mvvproject/ReVerSE-U16/u16_nextzx/readme.md

#### NextZX
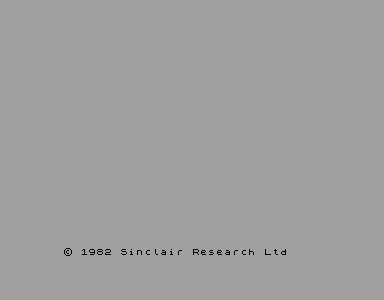
[picture p2: u16_nextzx/screen.png]


- CPU NextZ80@48MHz
- ROM 16K
- RAM 48K
- Video HDMI 640x480@60Hz
- Sound Beeper (Delta-sigma stereo)
- USB Keyboard
