mvvproject/ReVerSE-U16/u16_zx128k/readme.txt

ZX-Spectrum 128K
		CPU: T80@3.5MHz
		RAM: M9K 56K (32K ROM + 8K ROM + 16K RAM)
		SDRAM: 640K (128K + 512K)
		Video: HDMI 640x480@60Hz(ZX-Spectrum screen x2 = H:32+256+32; V=24+192+24)
		Int: 60Hz (h_sync_on and v_sync_on)
		Sound: Stereo (Delta-sigma) AY3-8910 + Beeper
		Keyboard: USB HID Keyboard (F4=CPU Reset, F5=NMI, ScrollLock=Hard Reset)
		DivMMC: 512K (Press Space+F5+F4 to initial, F5=Go to ESXDOS)

22.06.2015	Initial Audio Packets
07.06.2015	Initial release
