mvvproject/ReVerSE-U16/u16_zx48k/readme.md

#### ZX-48K


CPU: NextZ80 @ 50MHz

ROM: 16K

RAM: 48K

Video: HDMI 640x480 @ 60Hz

Sound: Beeper (Delta-sigma stereo)

Keyboard: USB
