mvvproject/ReVerSE-U16/u16_zx48k_t80/readme.txt

ZX-Spectrum 48K

CPU: T80@50MHz
RAM: M9K 64K (16K ROM + 48K RAM)
Video: HDMI 640x480@60Hz(ZX-Spectrum screen x2 = H:32+256+32; V=24+192+24)
Int: 60Hz (h_sync_on and v_sync_on)
Sound: Stereo (Delta-sigma)
Keyboard: USB HID Keyboard
