mvvproject/ReVerSE-U16/u16_board/modules/ubus/readme.txt

ReVerSE-U16 Adapter uBUS

09.06.2015	Rev.A Первая версия
16.09.2015	Rev.B Добавлены светодиоды LED1-8
05.10.2015	Rev.C Добавлена поддержка слотов расширения ZX-Bus, Nemo-Bus, NES, MSX-Bus
