mvvproject/ReVerSE-U16/u16_msx/readme.txt

OneChipMSX (сборка 20170405)
основана на http://www.caro.su/msx/ocm_de1.htm

1) Отформатируйте SD карту в FAT16 на PC
2) Запишите на неё первым файлом bios_m2p.rom из архива sd.zip
3) Запишите остальные файлы из архива sd.zip
4) Подключите к плате ReVerSE-U16 кабель HDMI, USB клавиатуру, аудио (используйте модуль https://github.com/mvvproject/ReVerSE-U16/tree/master/u16_board/modules/audio) и включите питание платы
5) Откройте в Quartus Programmer файл .jic
6) Запрограммируйте ReVerSE-U16 и отключите питание ReVerSE-U16
7) Вставте SD карту в ReVerSE-U16 и включите питание
8) Для запуска SYMBOS наберите symb и нажмите ENTER
9) Для запуска игры наберите cd games и нажмите ENTER, набирите dir, набирите romload mg2-uk /s

Управление указателем в SYMBOS с помощью клавиш F6 + курсорные клавиши (вверх, вниз, влево, вправо, пробел)

Специальные клавиши на клавиатуре:
Page Up		Добавить громкость звука
Page Down	Уменьшить громкость звука
F9		Добавить уровень звука в канале PSG
F9+SHIFT	Уменьшить уровень звука в канале PSG
F10		Добавить уровень звука в канале SCC
F10+SHIFT	Уменьшить уровень звука в канале SCC
F11		Добавить уровень звука в канале OPLL
F11+SHIFT	Уменьшить уровень звука в канале OPLL
F12		Переключение тактовой частоты процессора
