mvvproject/ReVerSE-U16/u16_board/modules/audio/u16_audio.jpg

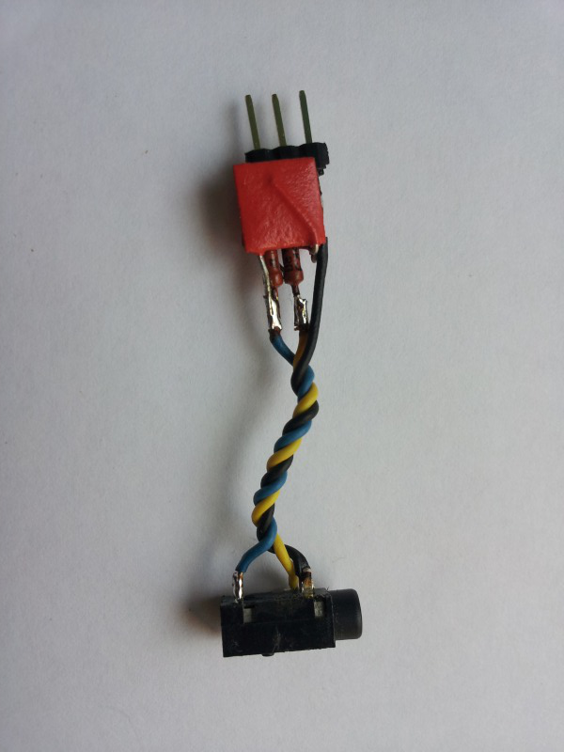
u16_board/modules/audio/u16_audio.jpg
