mvvproject/ReVerSE-U16/u16_board/modules/audio/u16c_audio.png

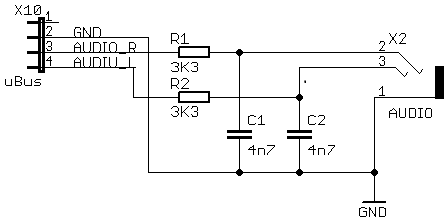
u16_board/modules/audio/u16c_audio.png
