mvvproject/ReVerSE-U16/u16_board/modules/ubus/photo/ubus_brd_rev_b_top.jpg

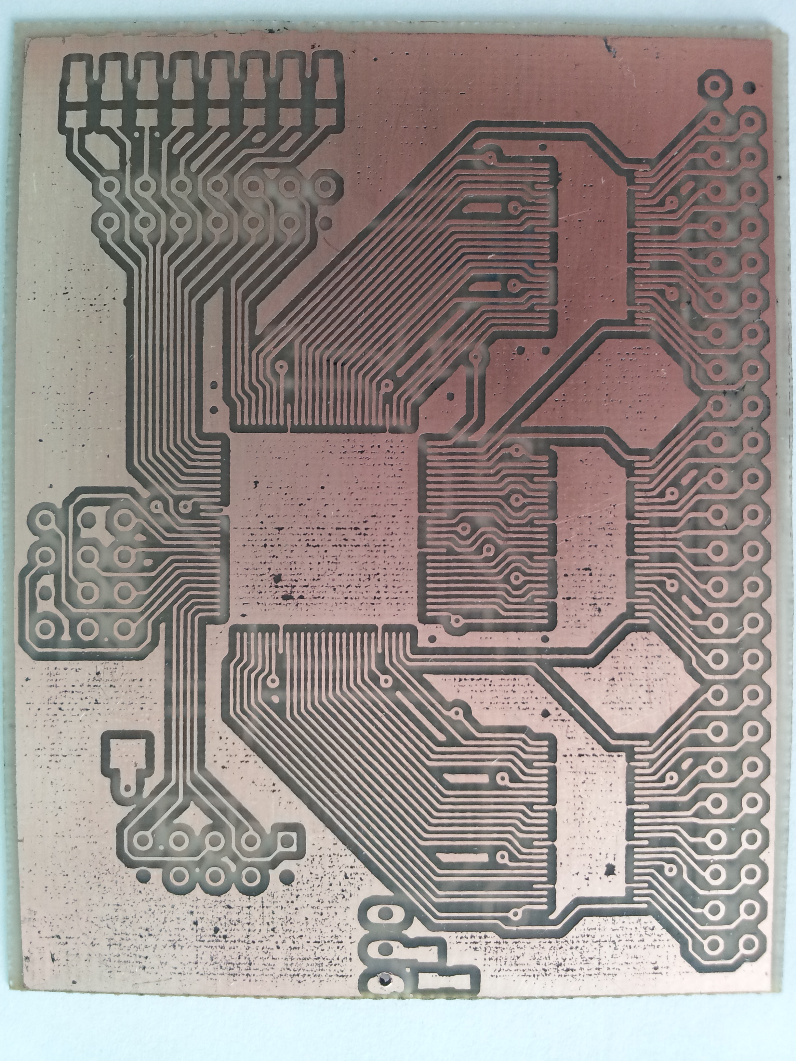
u16_board/modules/ubus/photo/ubus_brd_rev_b_top.jpg
