mvvproject/ReVerSE-U16/u16_board/modules/ubus/photo/ubus_rev_b_bottom.jpg

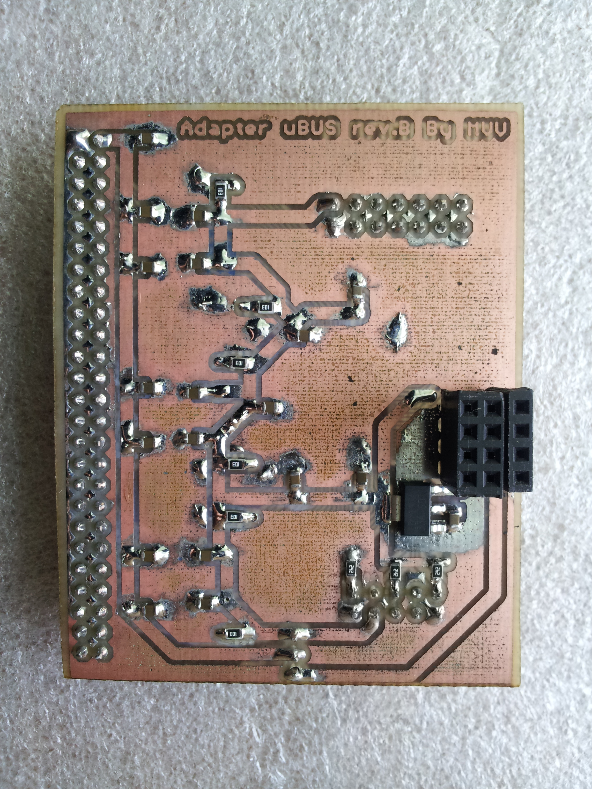
u16_board/modules/ubus/photo/ubus_rev_b_bottom.jpg
