mvvproject/ReVerSE-U16/u16_board/modules/ubus/ubus_rev_b.png

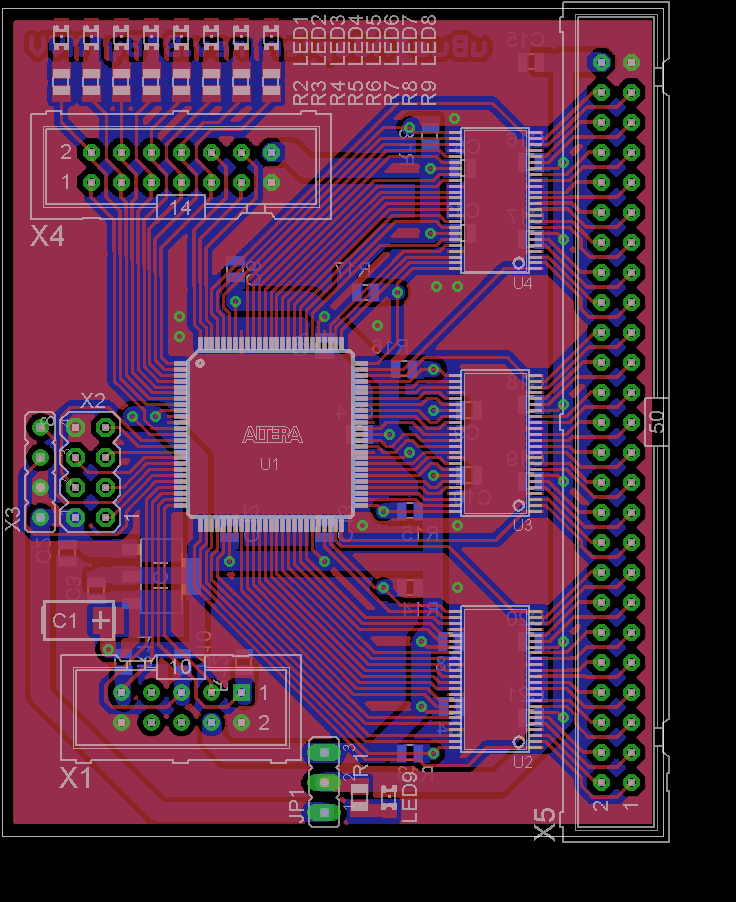
u16_board/modules/ubus/ubus_rev_b.png
