mvvproject/ReVerSE-U16/u16_board/modules/usb_blaster/pdf/usb_blaster_foto.jpg

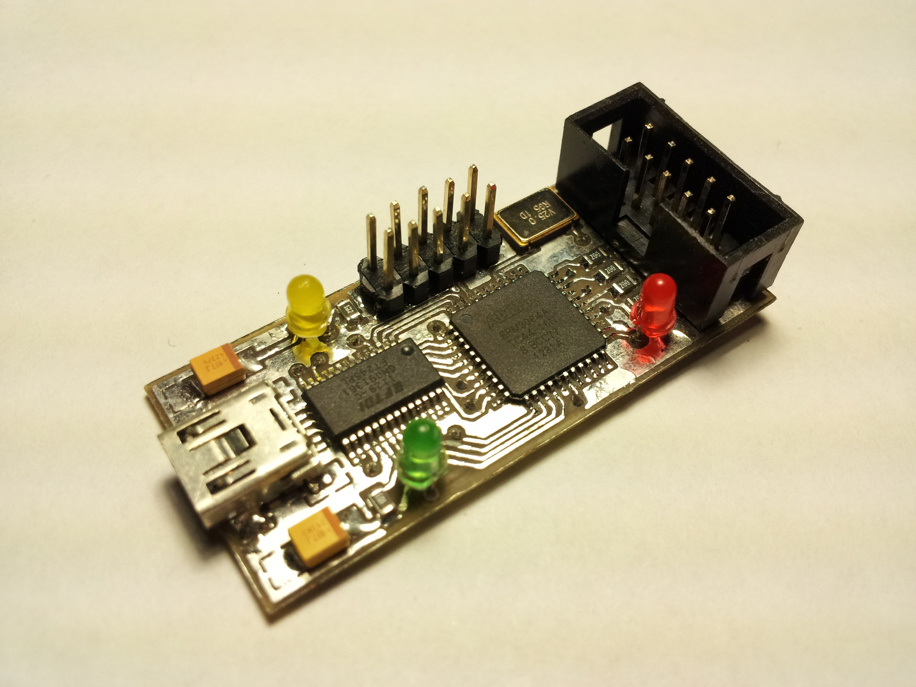
u16_board/modules/usb_blaster/pdf/usb_blaster_foto.jpg
