mvvproject/ReVerSE-U16/u16_board/modules/vdac2/u16c_vdac2b_sch.png

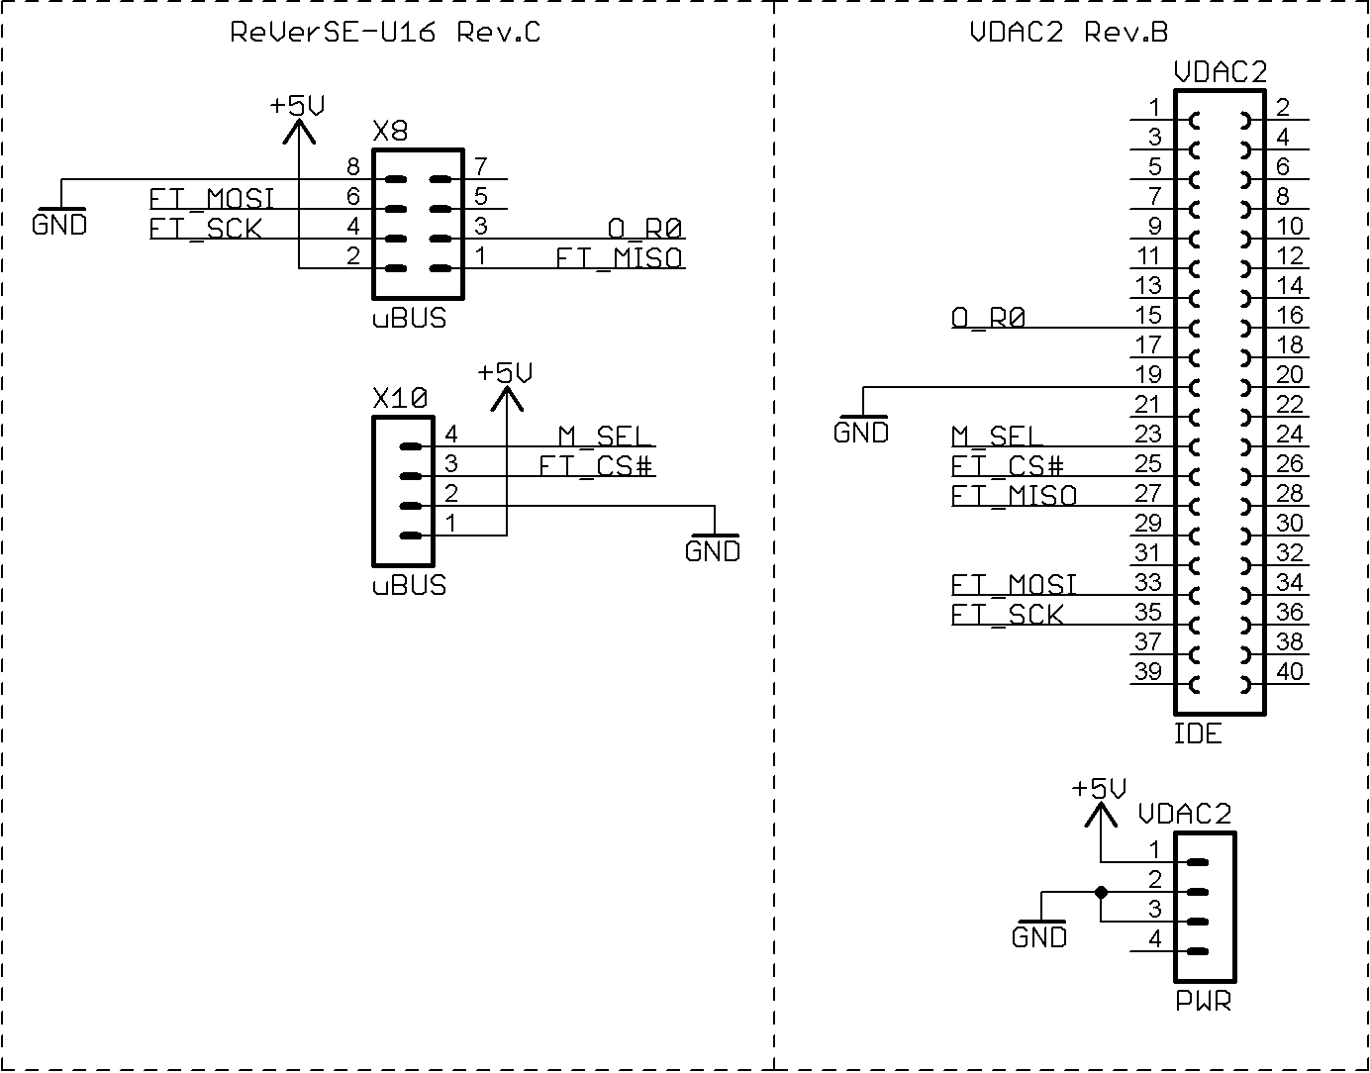
u16_board/modules/vdac2/u16c_vdac2b_sch.png
