mvvproject/ReVerSE-U16/u16_board/modules/vga/u16_hdmi2vga.jpg

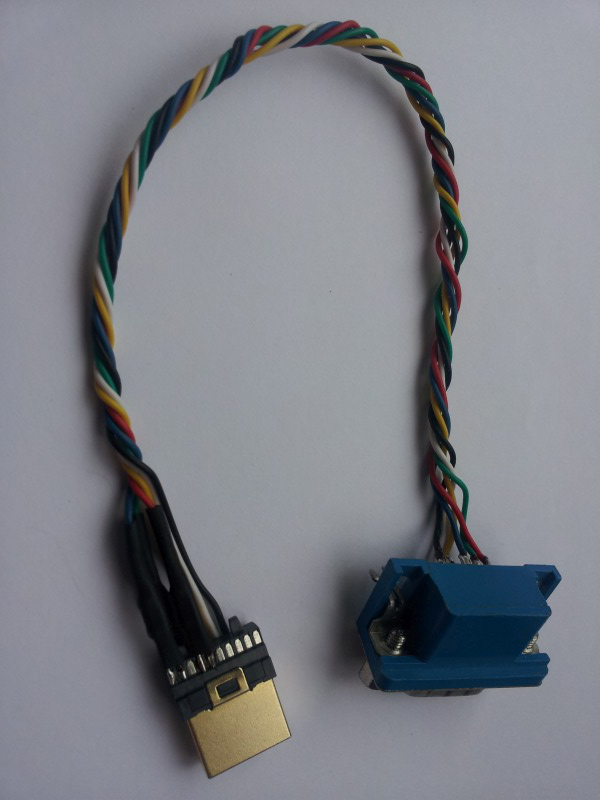
u16_board/modules/vga/u16_hdmi2vga.jpg
