mvvproject/ReVerSE-U16/u16_board/u16_board_rev_c/images/u16c_box_brd.jpg

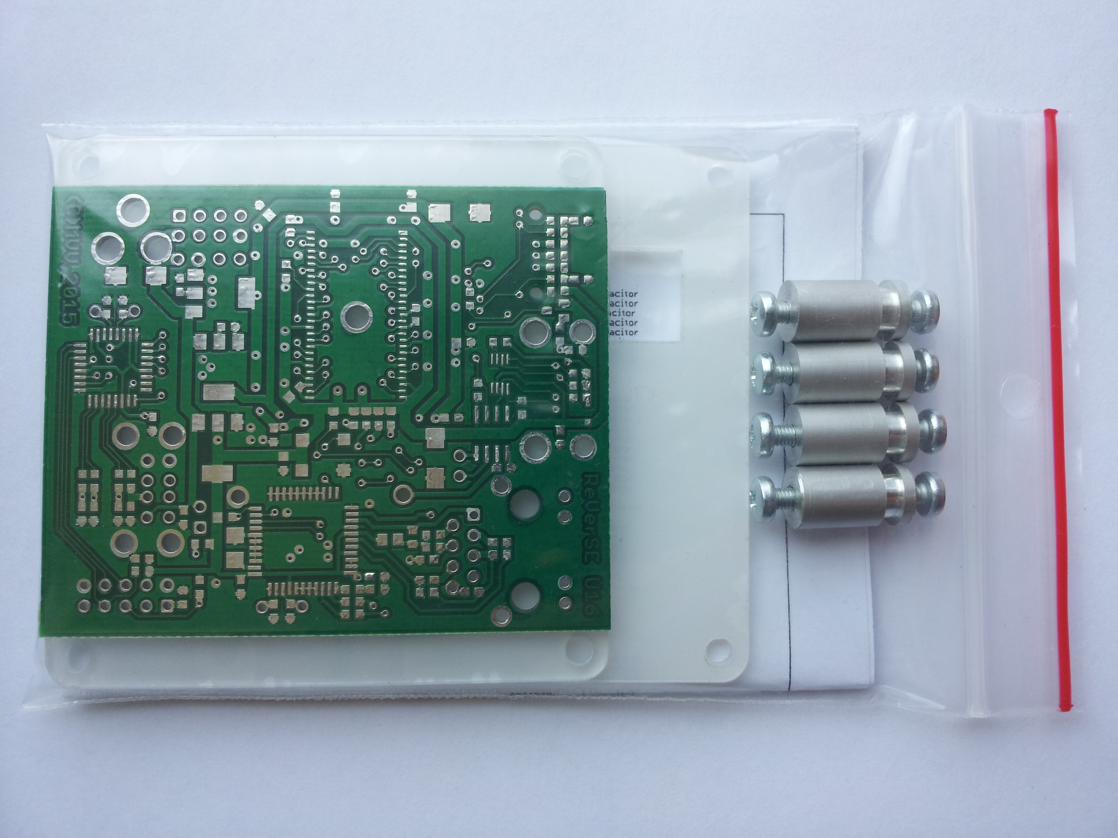
u16_board/u16_board_rev_c/images/u16c_box_brd.jpg
