mvvproject/ReVerSE-U16/u16_board/u16_board_rev_c/images/u16c_brd1.jpg

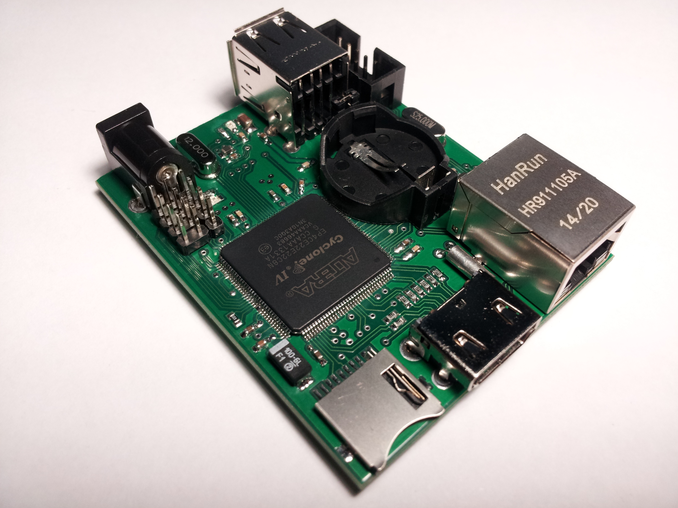
u16_board/u16_board_rev_c/images/u16c_brd1.jpg
