mvvproject/ReVerSE-U16/u16_zet/flash/JIC.JPG

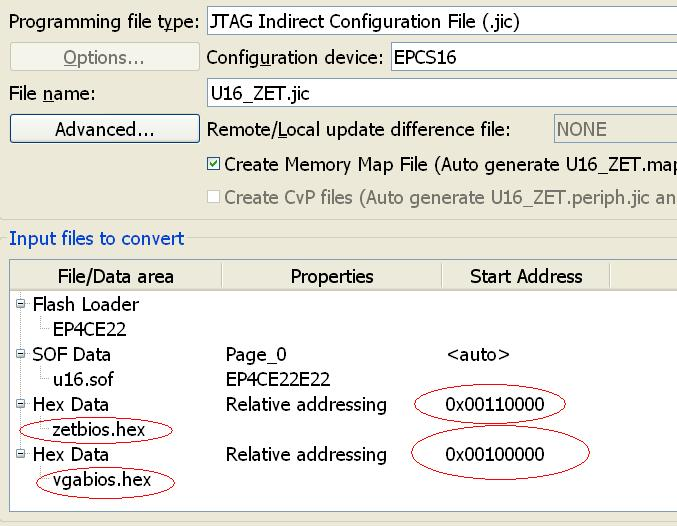
u16_zet/flash/JIC.JPG
