mvvproject/ReVerSE-U16/u16_zet/todo/Lo-tech 2MB EMS Board/Lo-tech-2MB-EMS-Board-tested.jpg

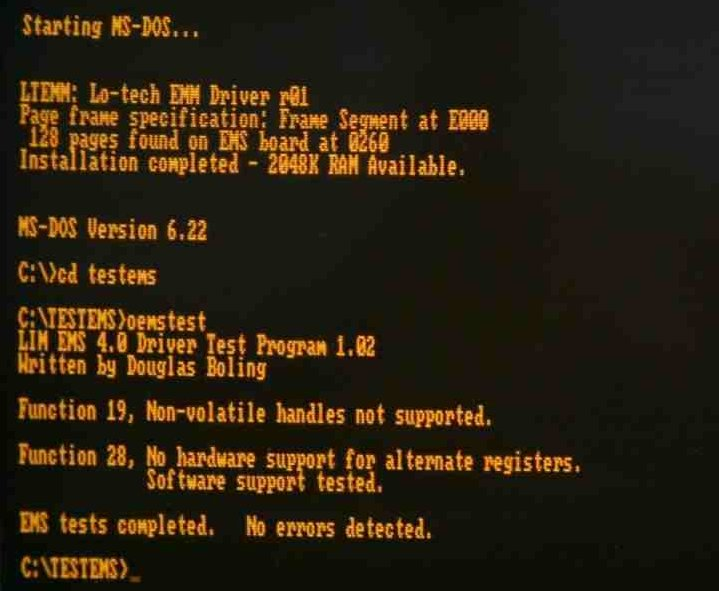
u16_zet/todo/Lo-tech 2MB EMS Board/Lo-tech-2MB-EMS-Board-tested.jpg
