mvvproject/ReVerSE-U16/u16_board/modules/v2debug/v2debug.jpg

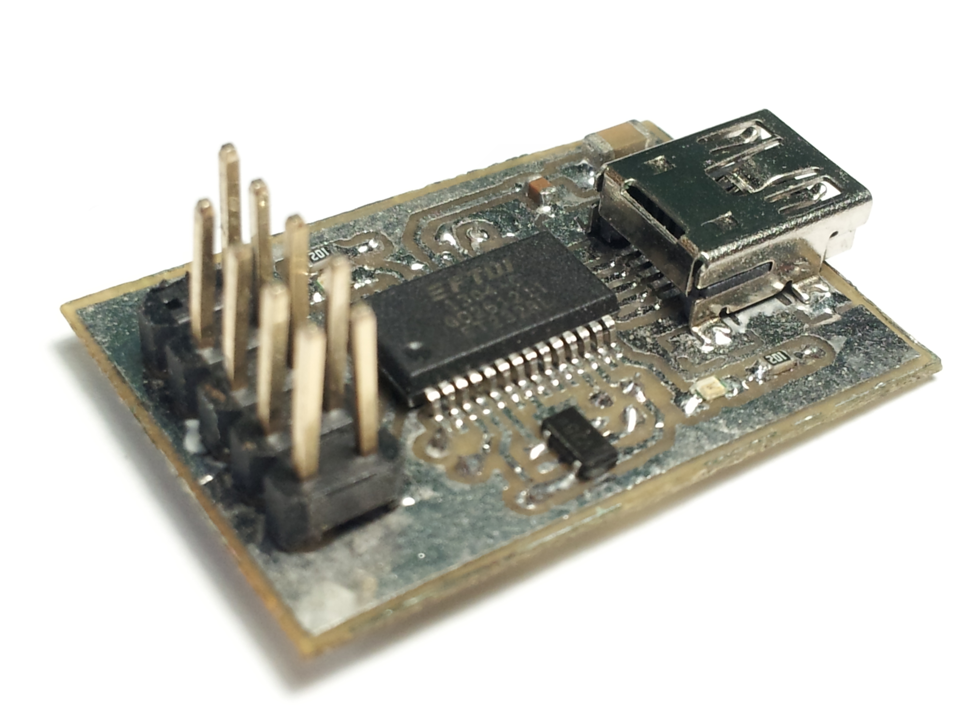
u16_board/modules/v2debug/v2debug.jpg
