mvvproject/ReVerSE-U16/u16_board/modules/v2debug/v2debug.pdf

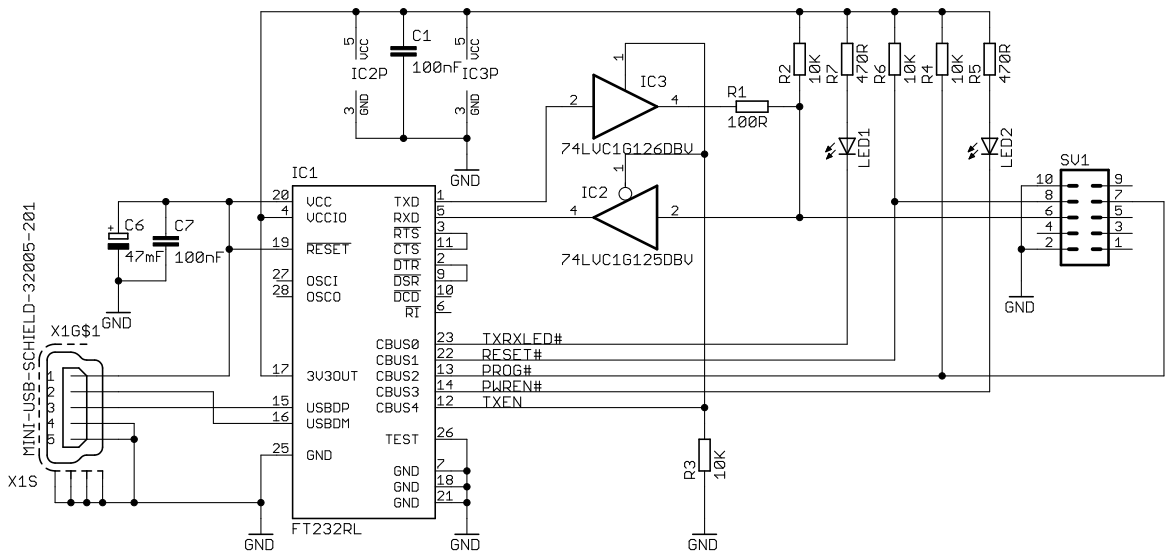
[picture p47: page 1]

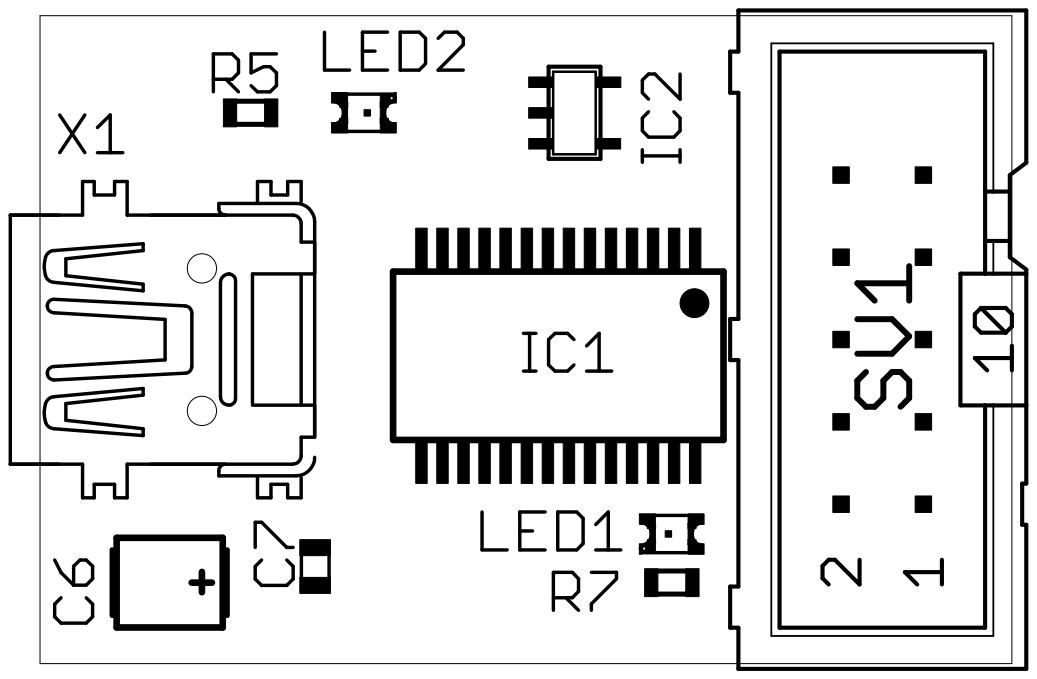
[picture p48: page 2]

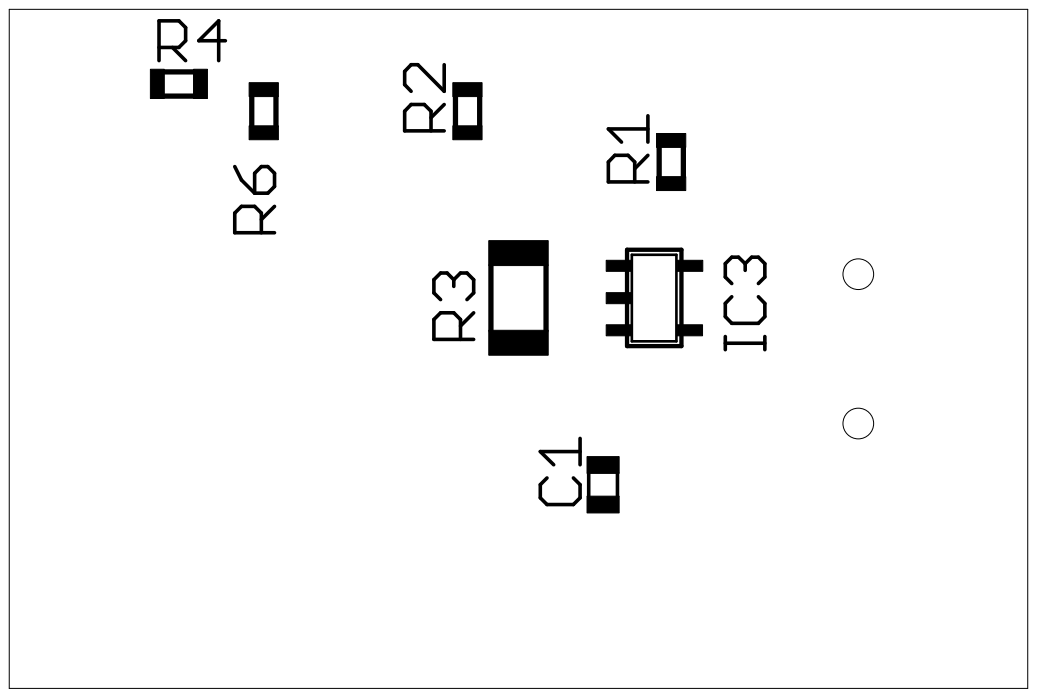
[picture p49: page 3]

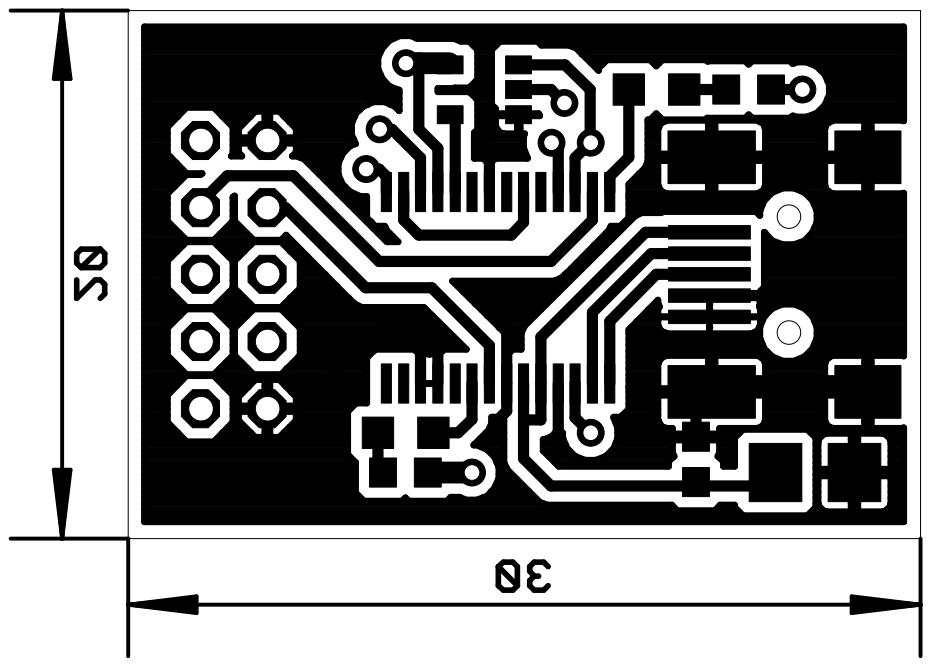
[picture p50: page 4]

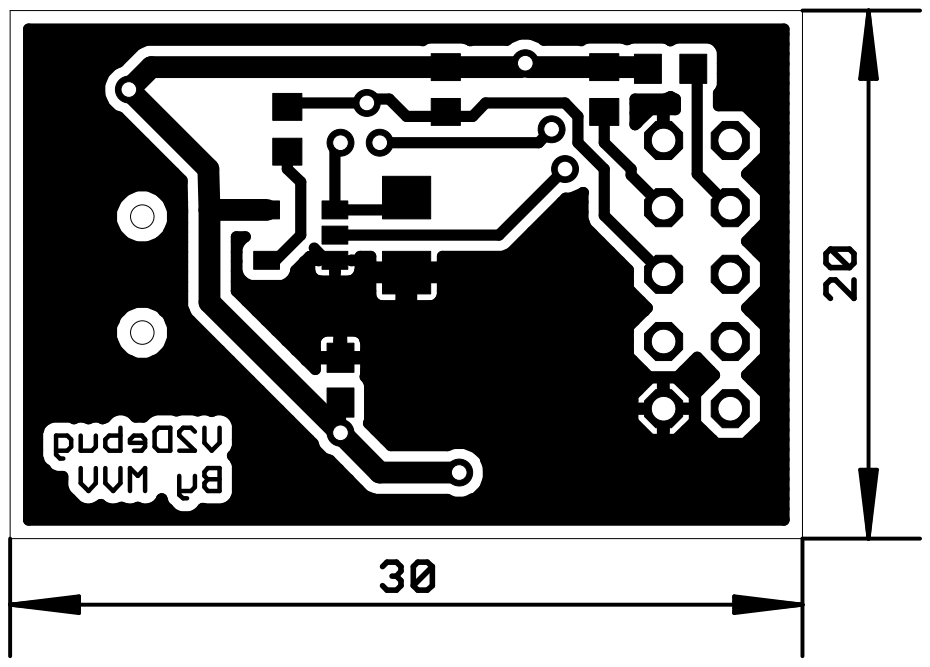
[picture p51: page 5]
