mvvproject/ReVerSE-U16/u16_board/modules/ubus/ubus_rev_b_sch.pdf

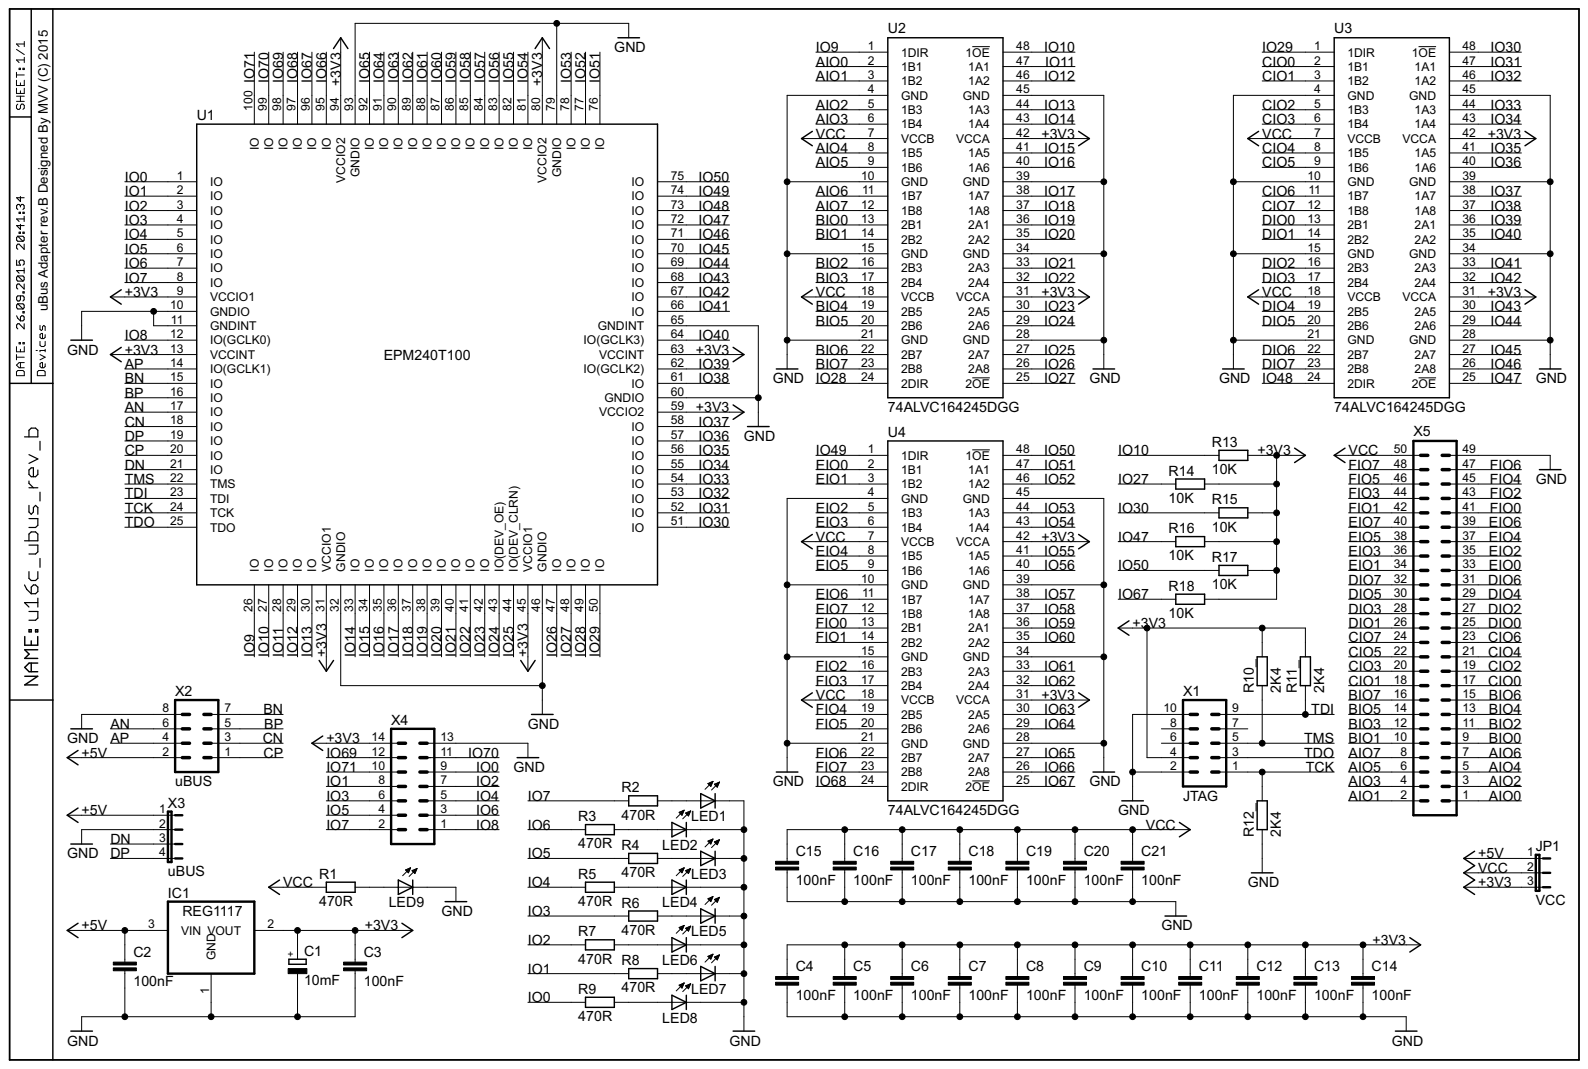
[picture p52: page 1]

uBus Adapter rev.B Designed By MVV (C) 2015

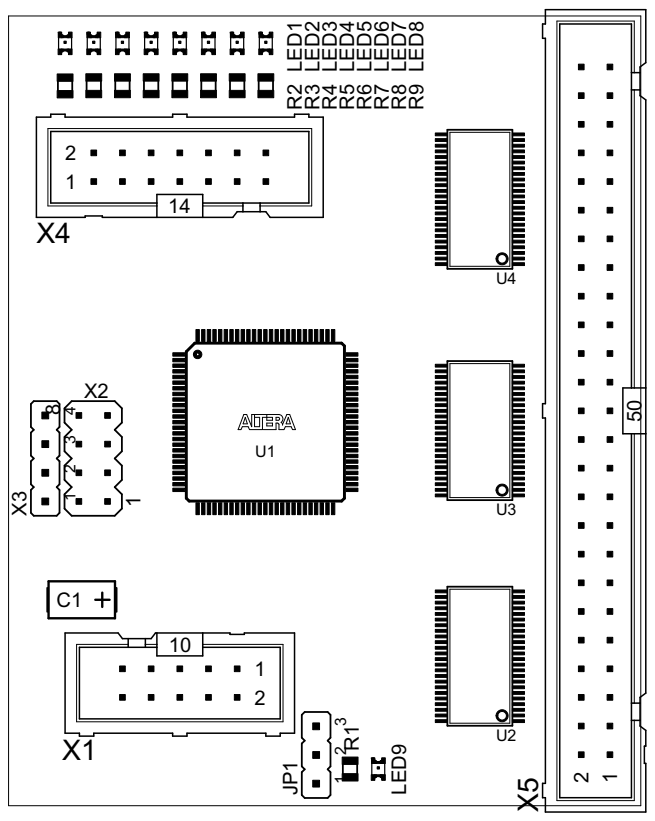
[picture p53: page 2]

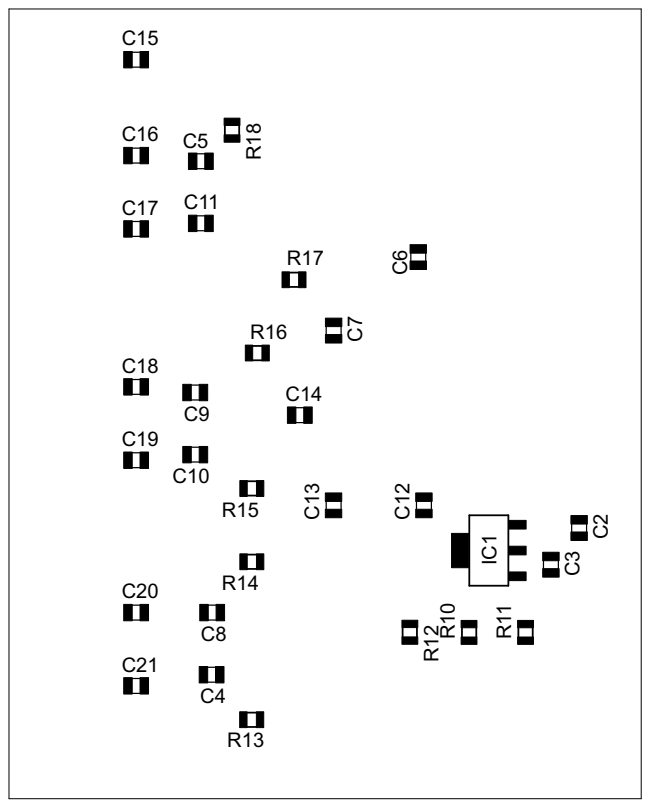
[picture p54: page 3]

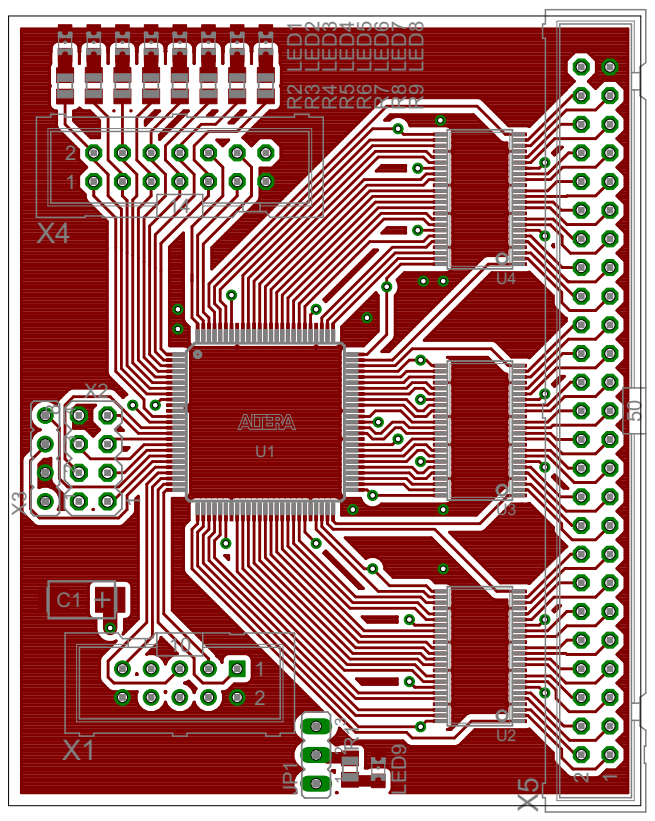
[picture p55: page 4]

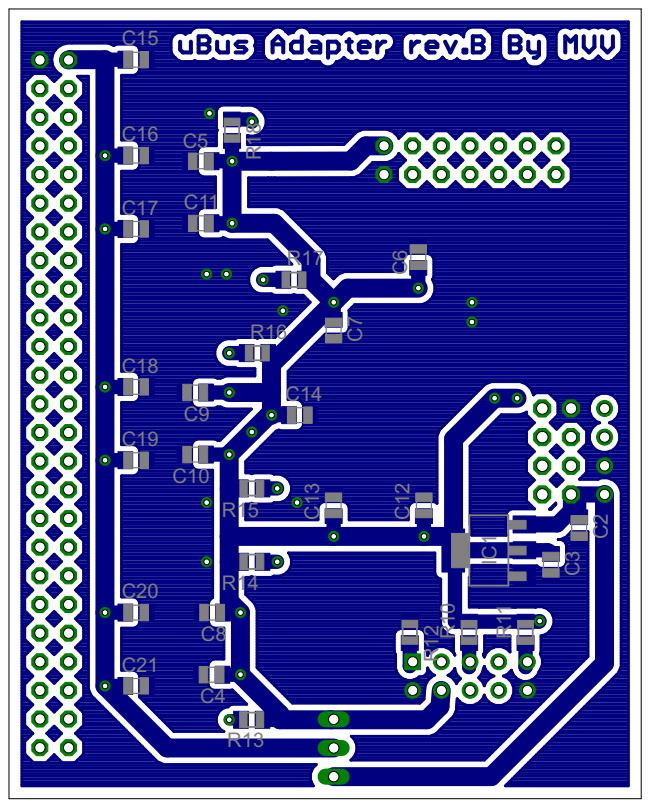
[picture p56: page 5]
