mvvproject/ReVerSE-U16/u16_board/modules/vga/u16_hdmi2vga.pdf

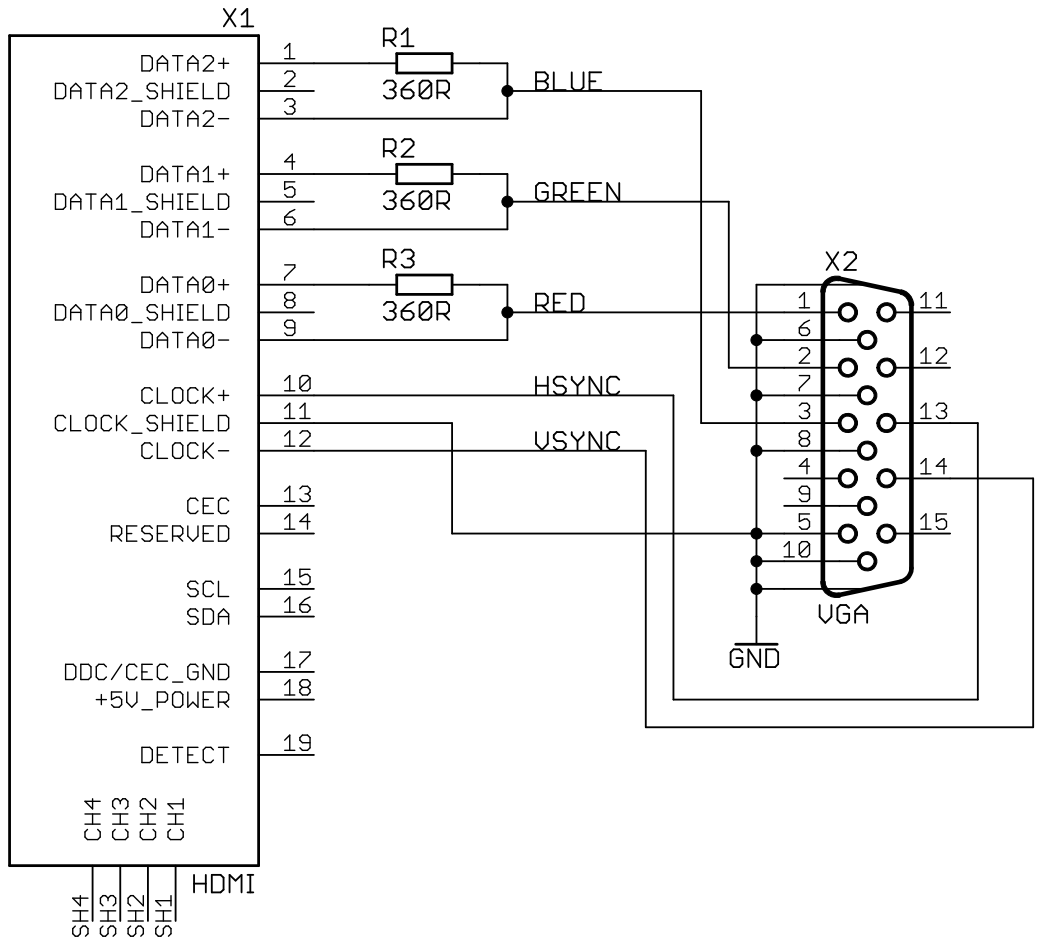
[picture p57: page 1]
