mvvproject/ReVerSE-U16/u16_board/modules/usb_blaster/pdf/usb_blaster_bot.pdf

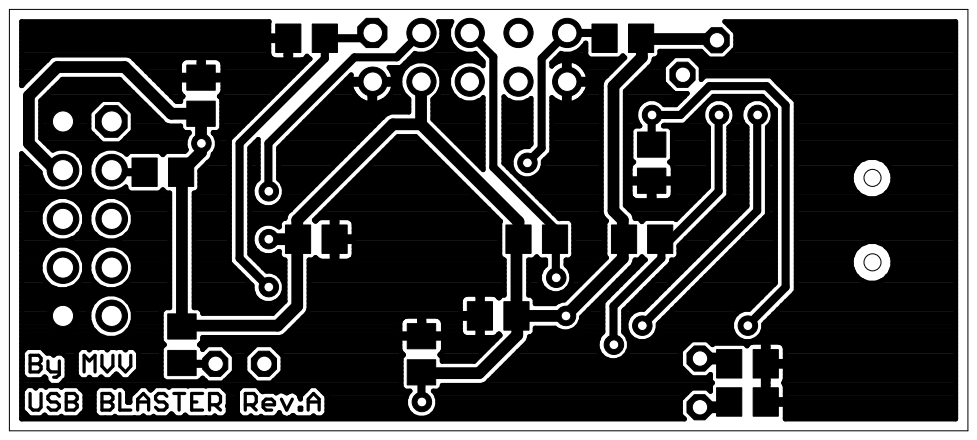
[picture p58: page 1]
