mvvproject/ReVerSE-U16/u16_board/modules/usb_blaster/pdf/usb_blaster_doca.pdf

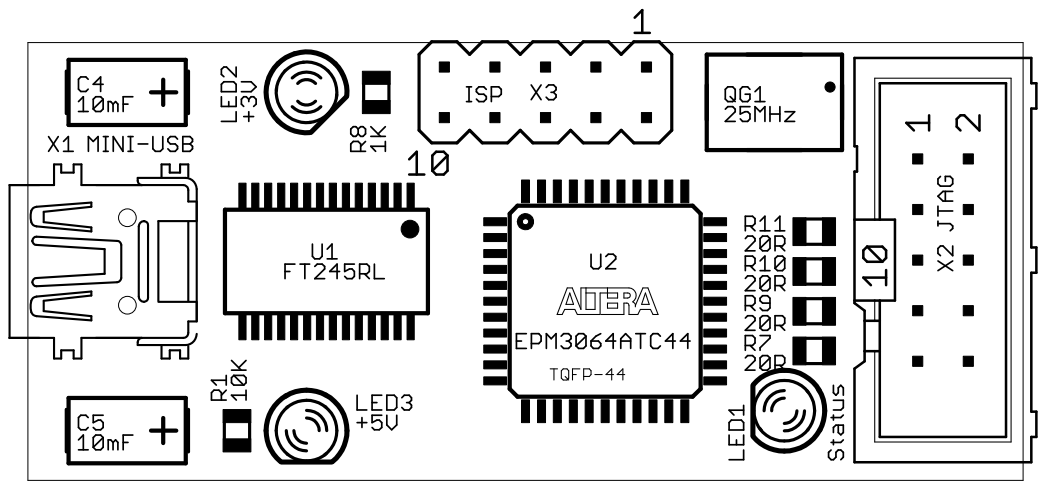
[picture p59: page 1]
