mvvproject/ReVerSE-U16/u16_board/modules/usb_blaster/pdf/usb_blaster_docb.pdf

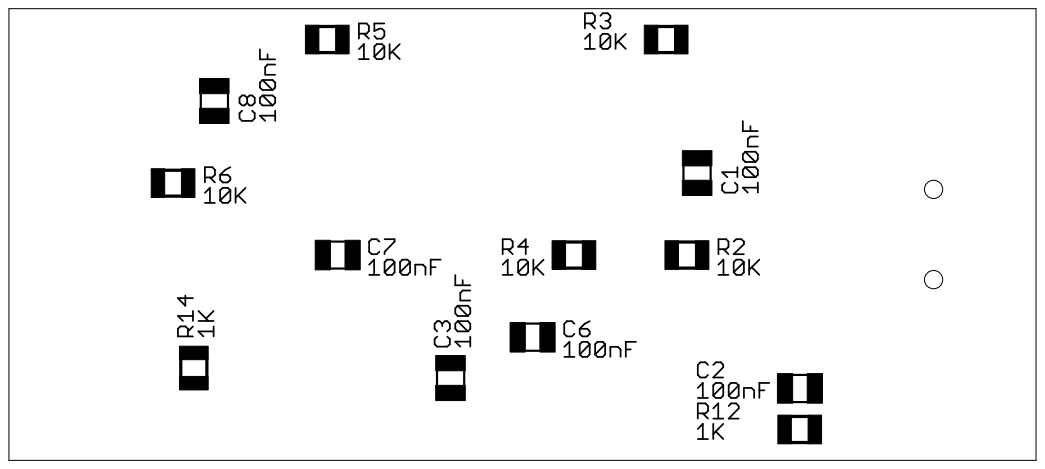
[picture p60: page 1]
