mvvproject/ReVerSE-U16/u16_board/modules/usb_blaster/pdf/usb_blaster_rev_a.pdf

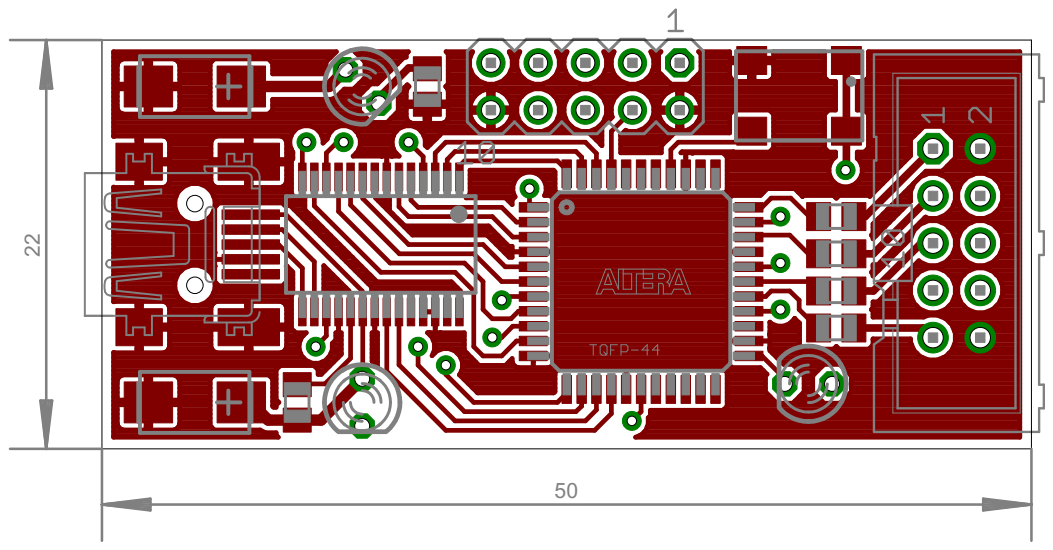
[picture p61: page 1]
