mvvproject/ReVerSE-U16/u16_board/modules/usb_blaster/pdf/usb_blaster_sch.pdf

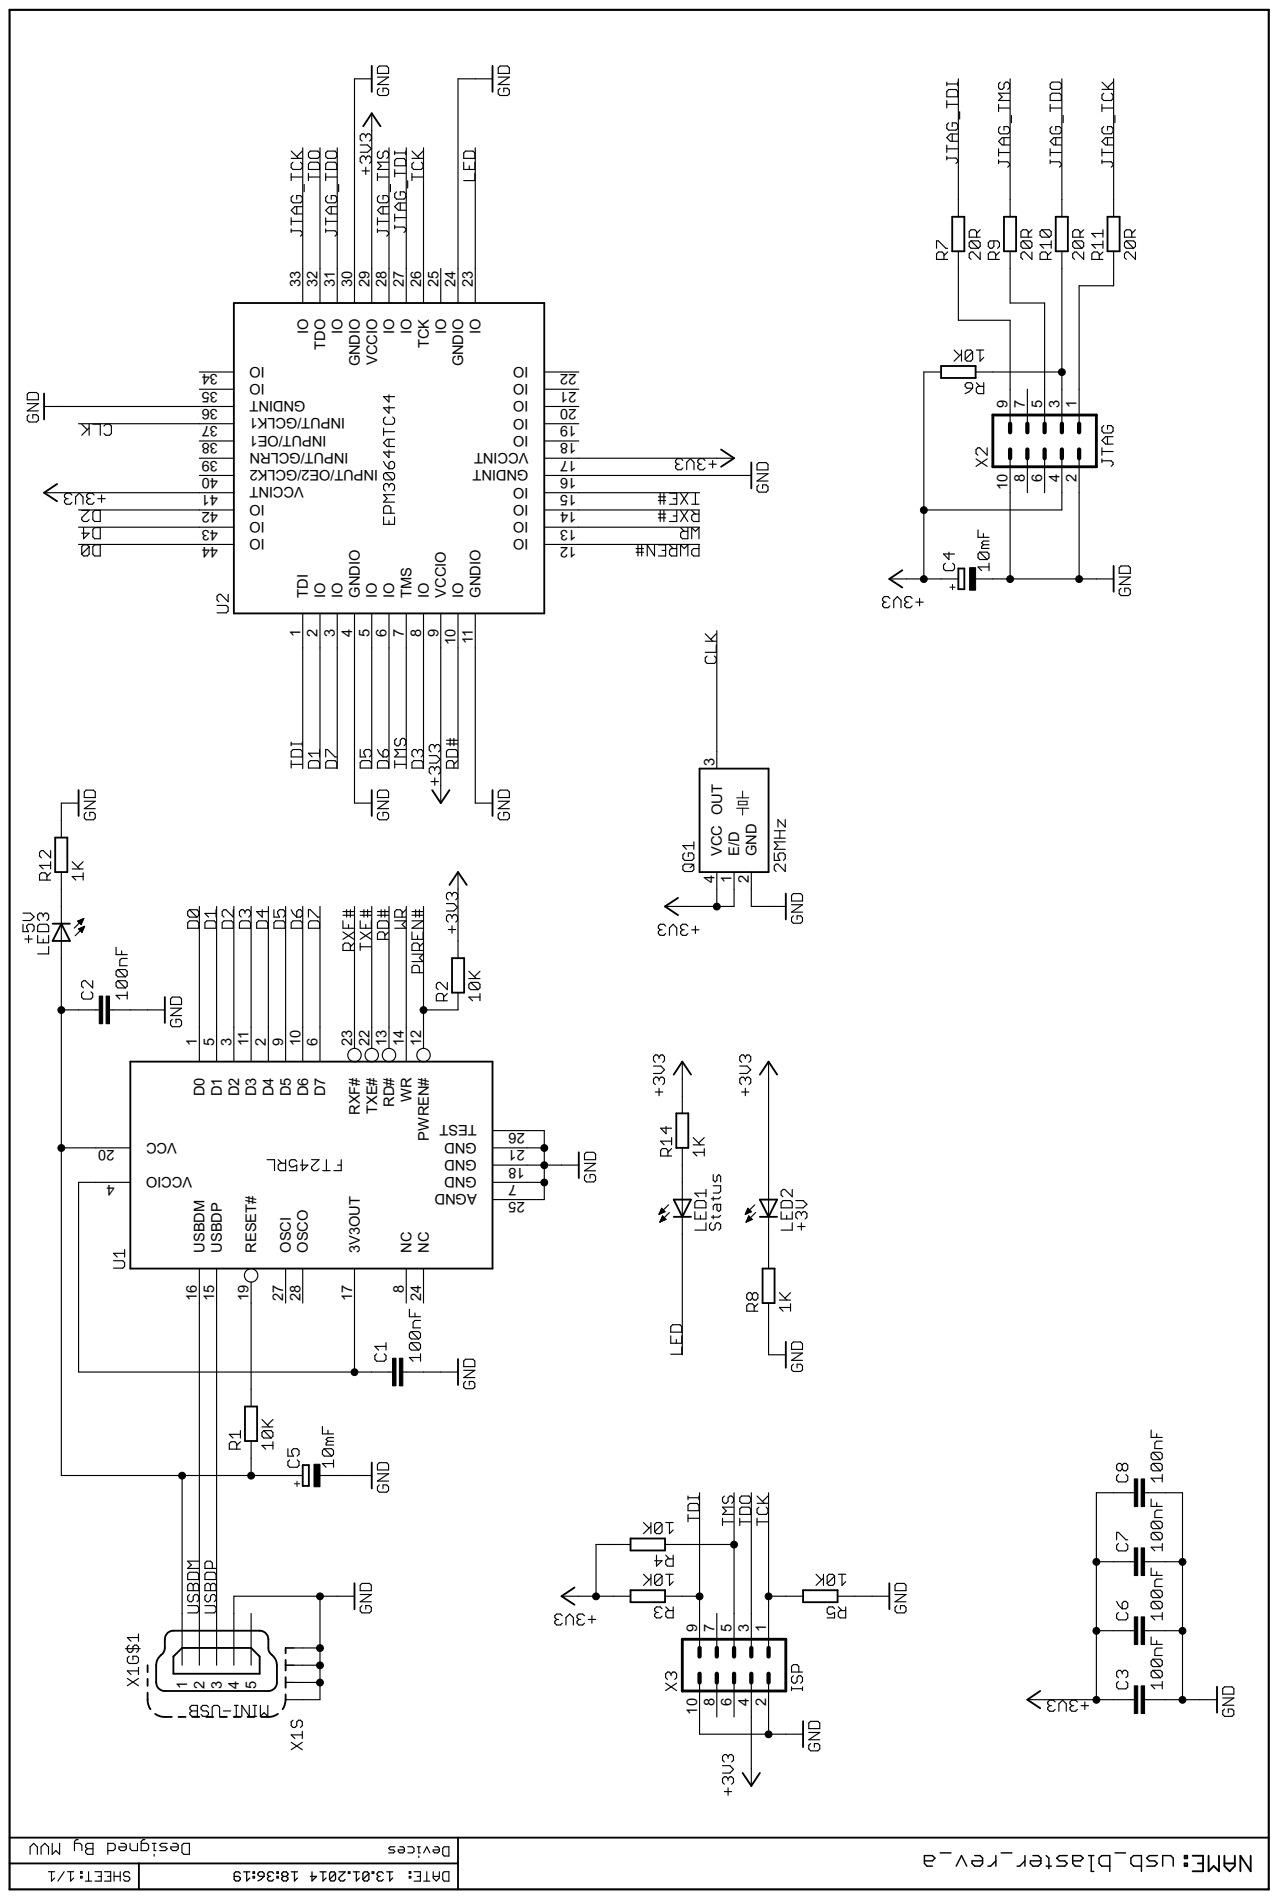
[picture p62: page 1]
