mvvproject/ReVerSE-U16/u16_board/modules/usb_blaster/pdf/usb_blaster_top.pdf

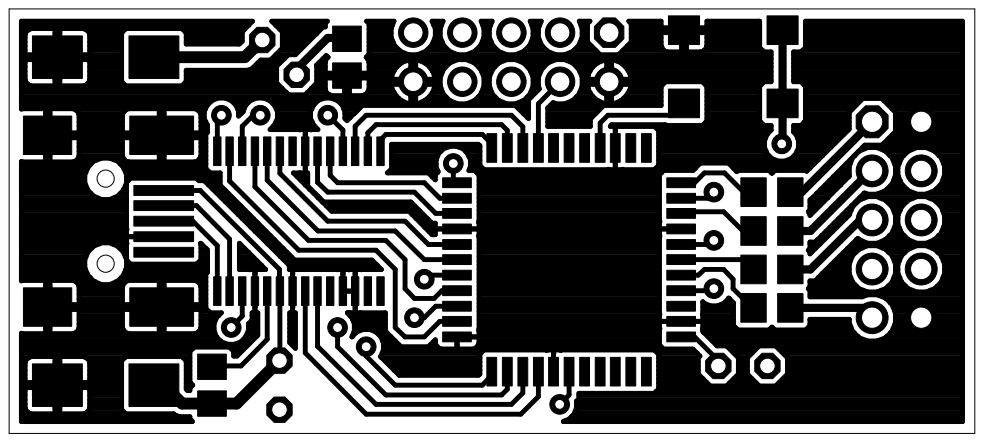
[picture p63: page 1]
