mvvproject/ReVerSE-U16/u16_board/u16_board_rev_c/manuals/u16_sch_rev_c.pdf

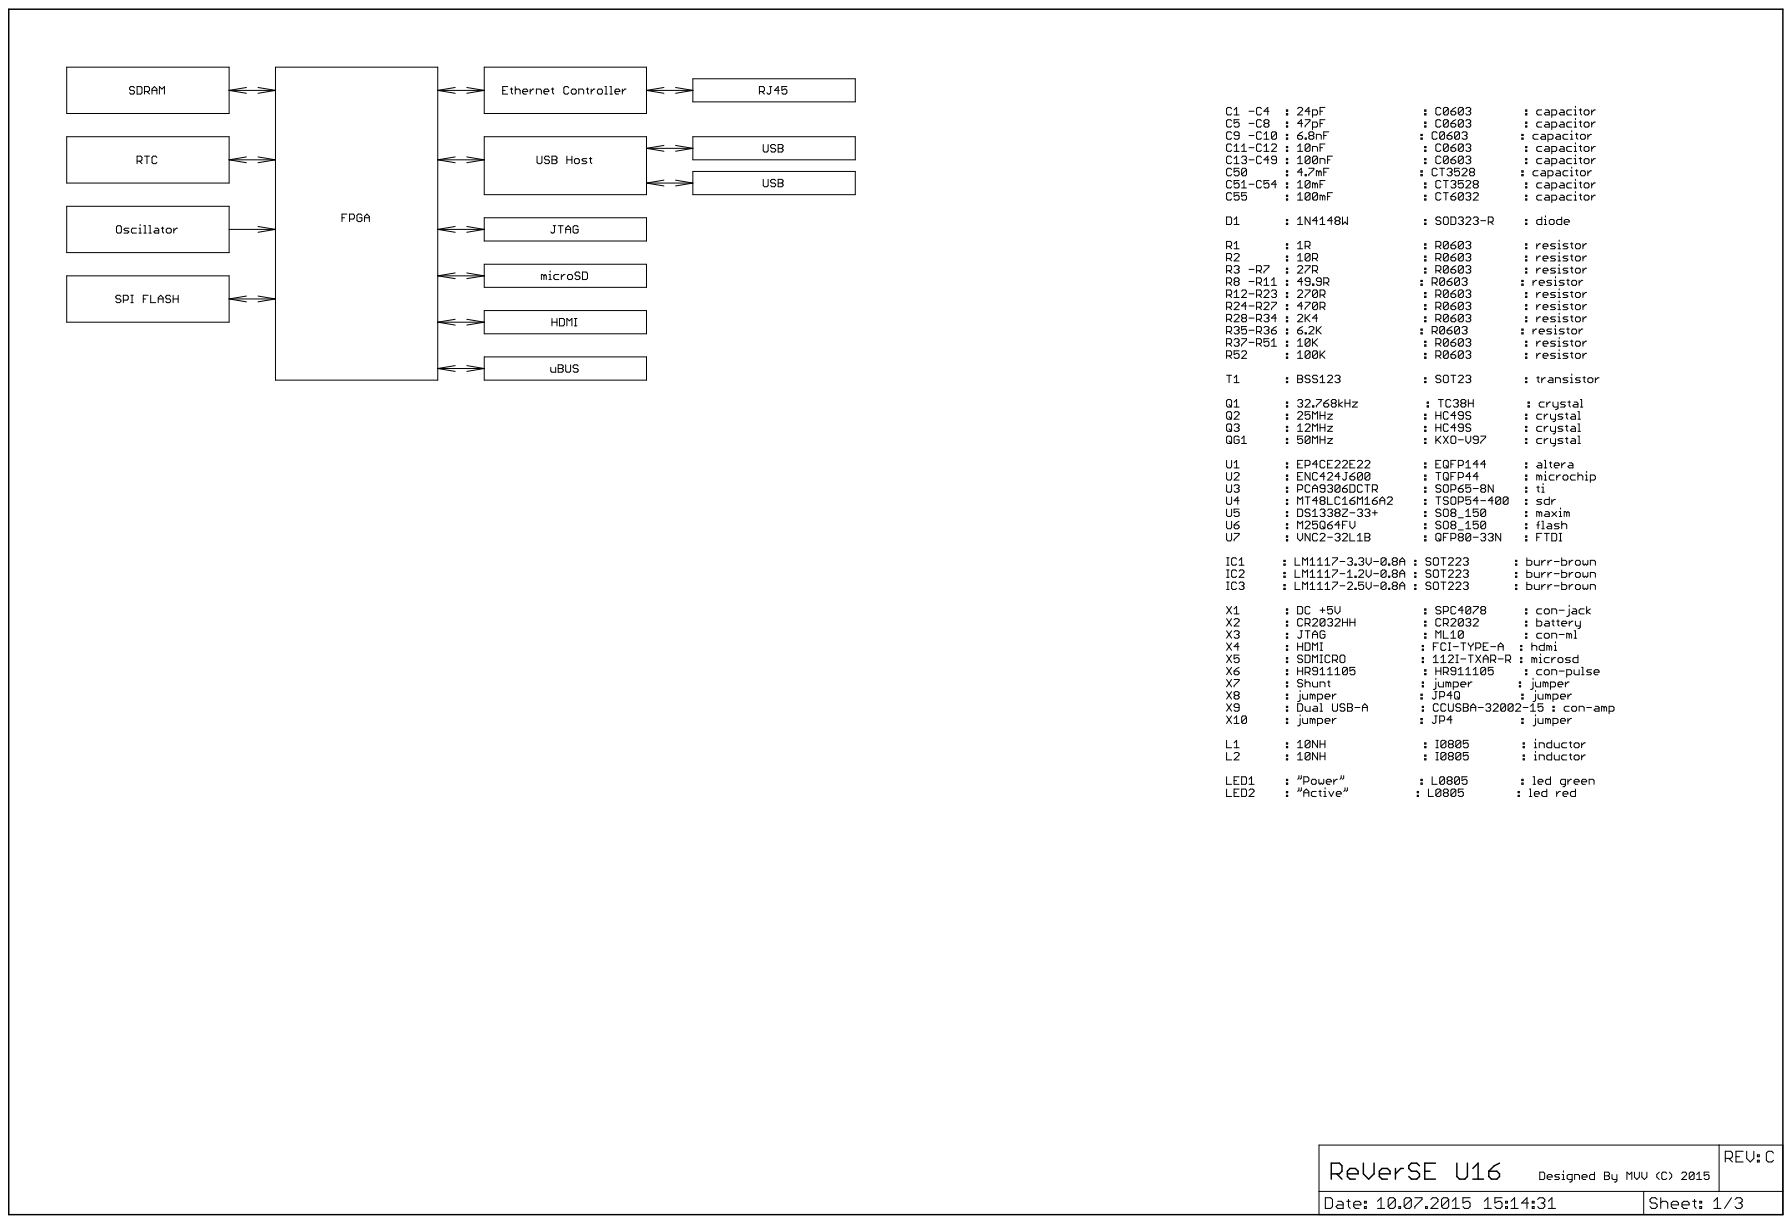
[picture p64: page 1]

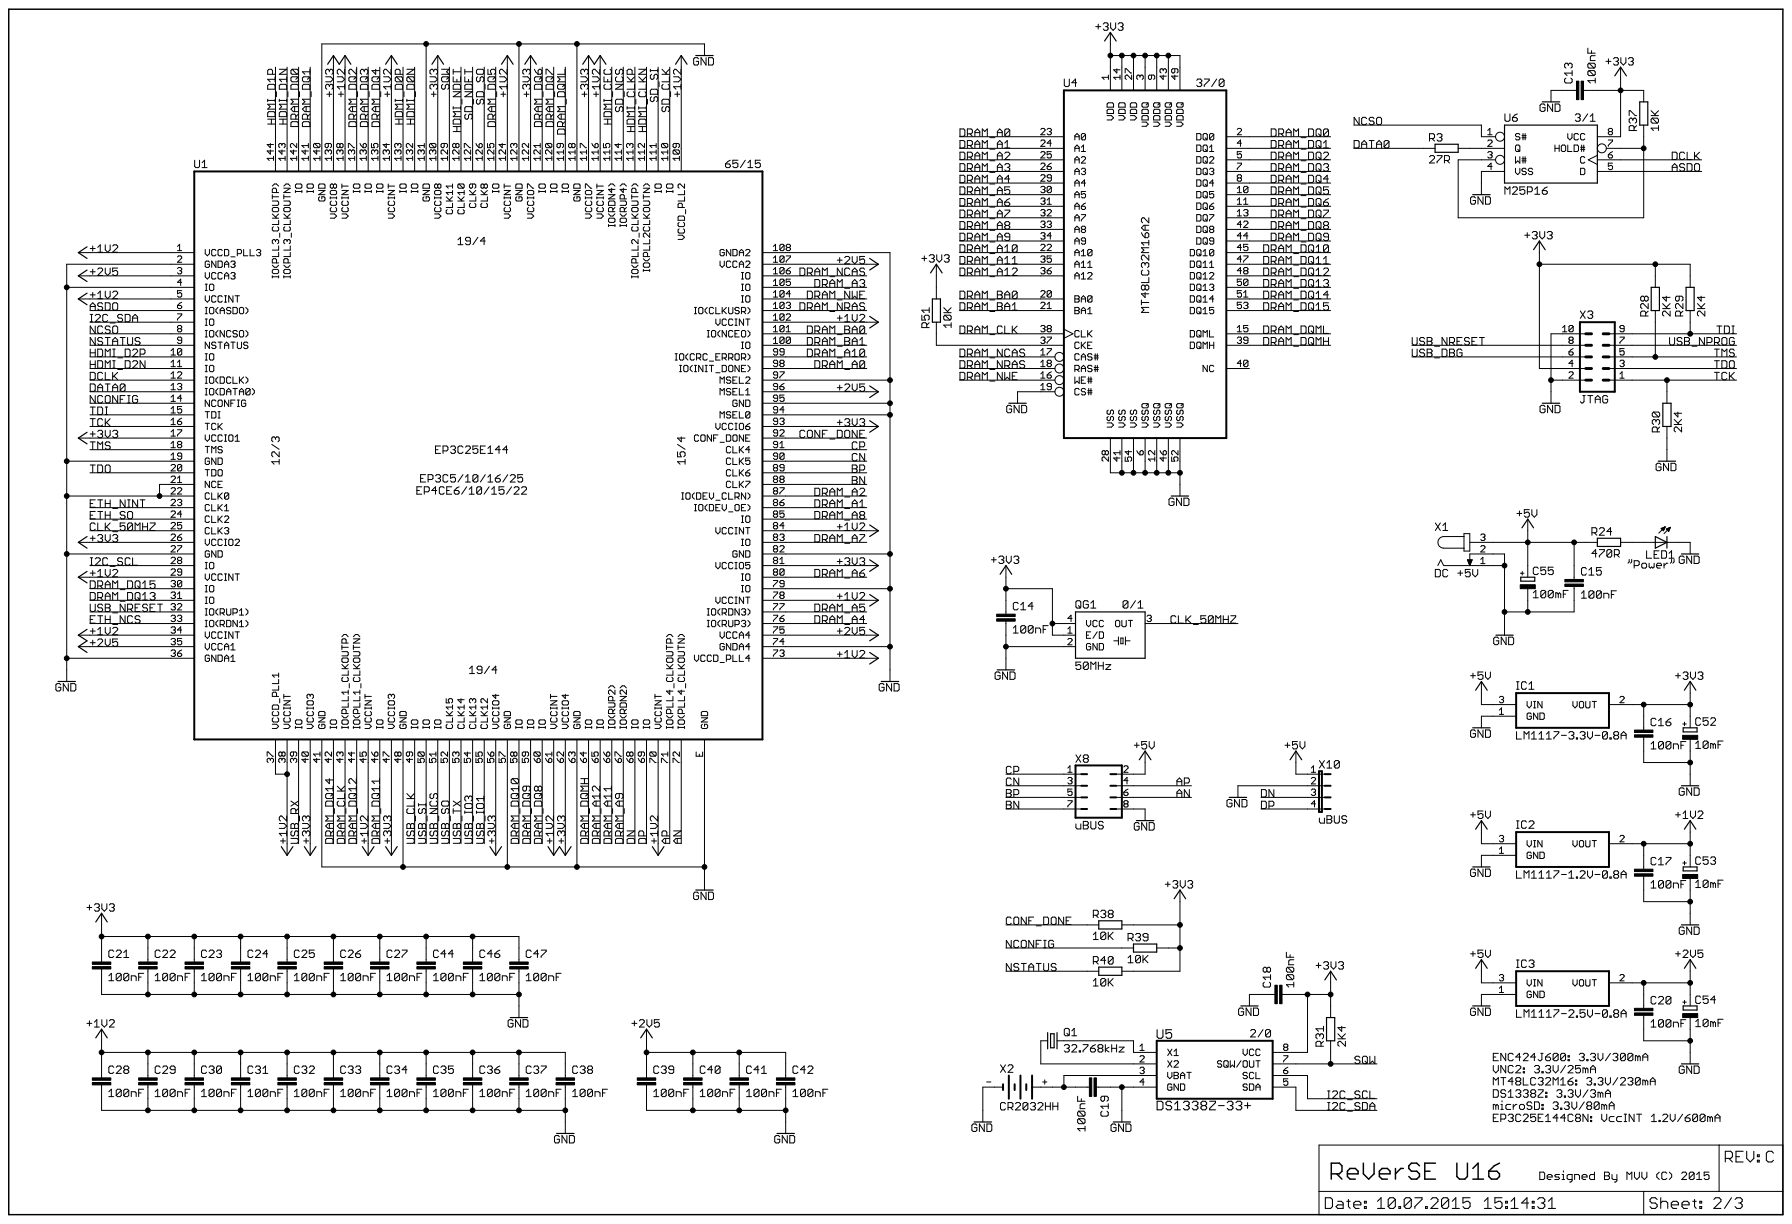
[picture p65: page 2]

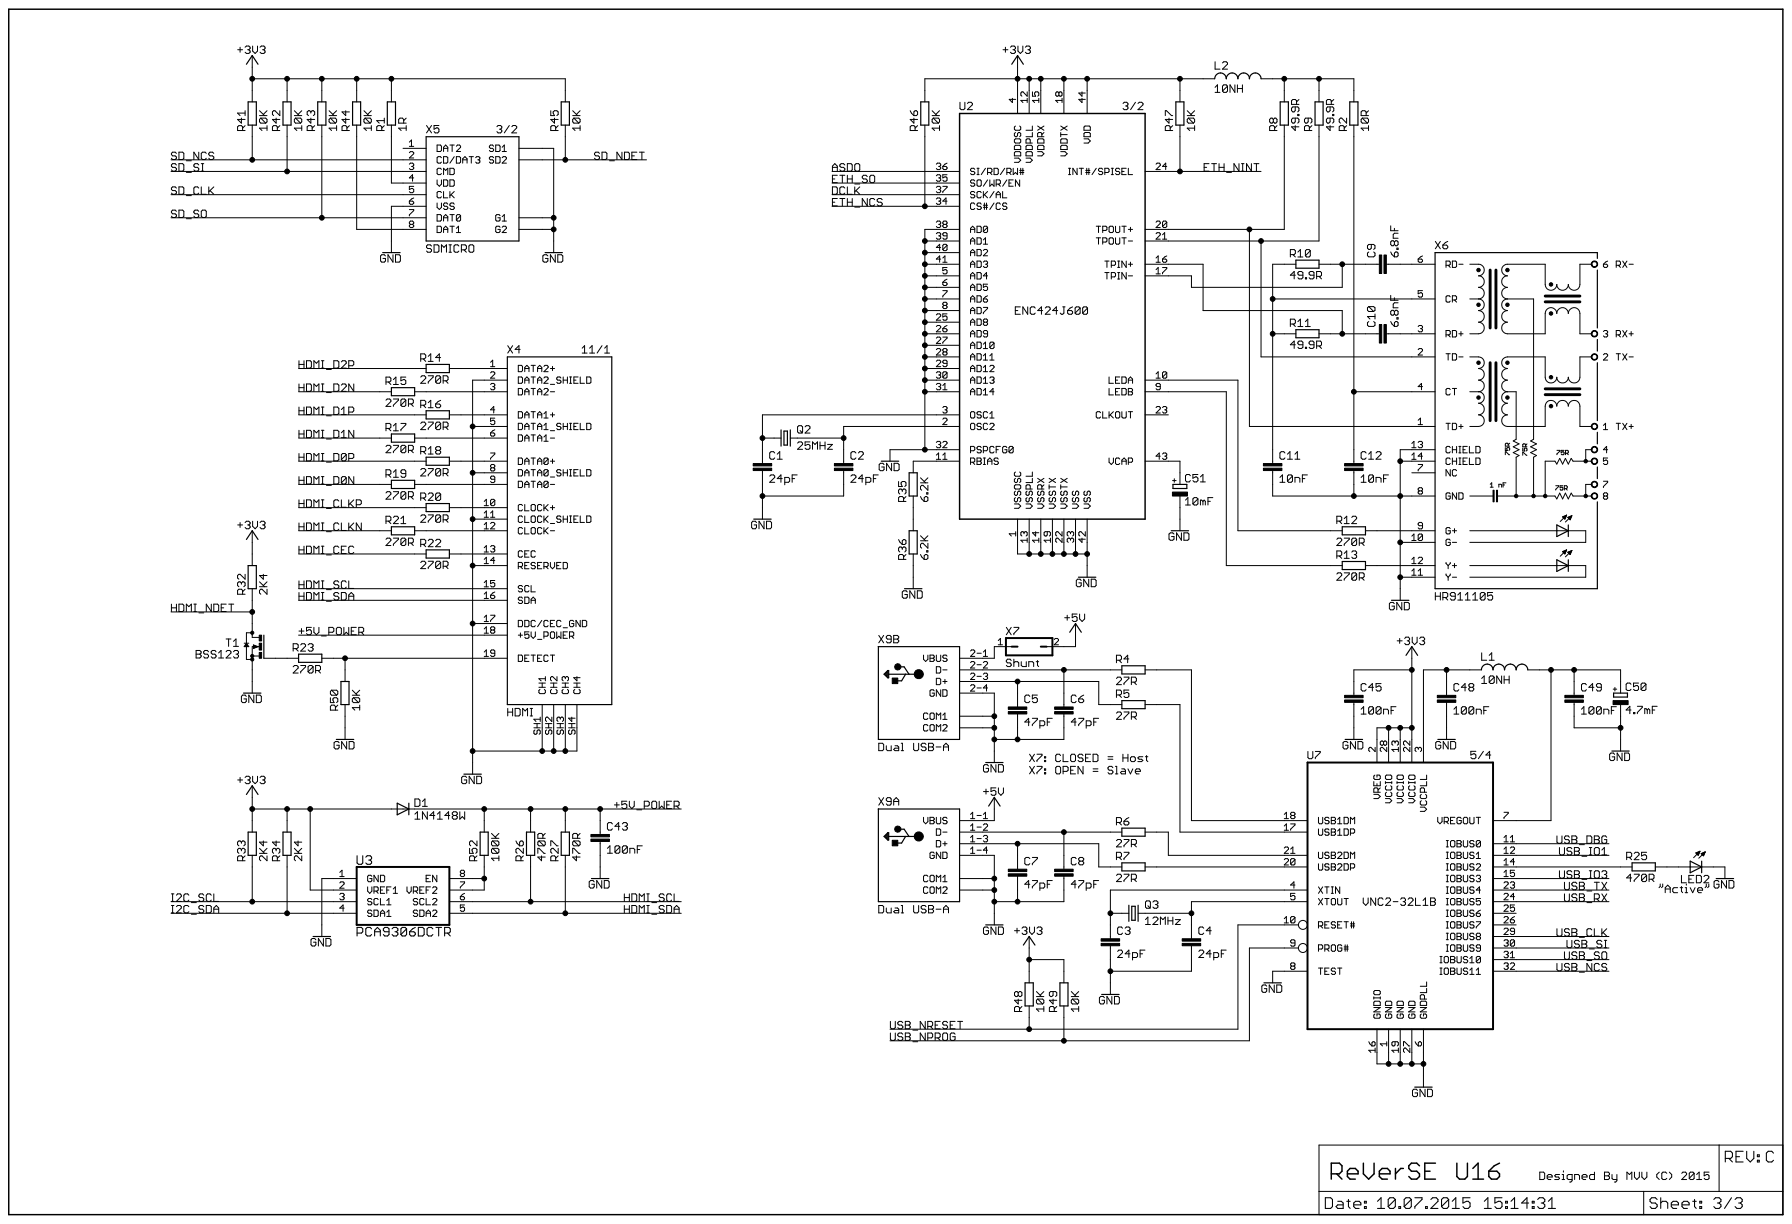
[picture p66: page 3]

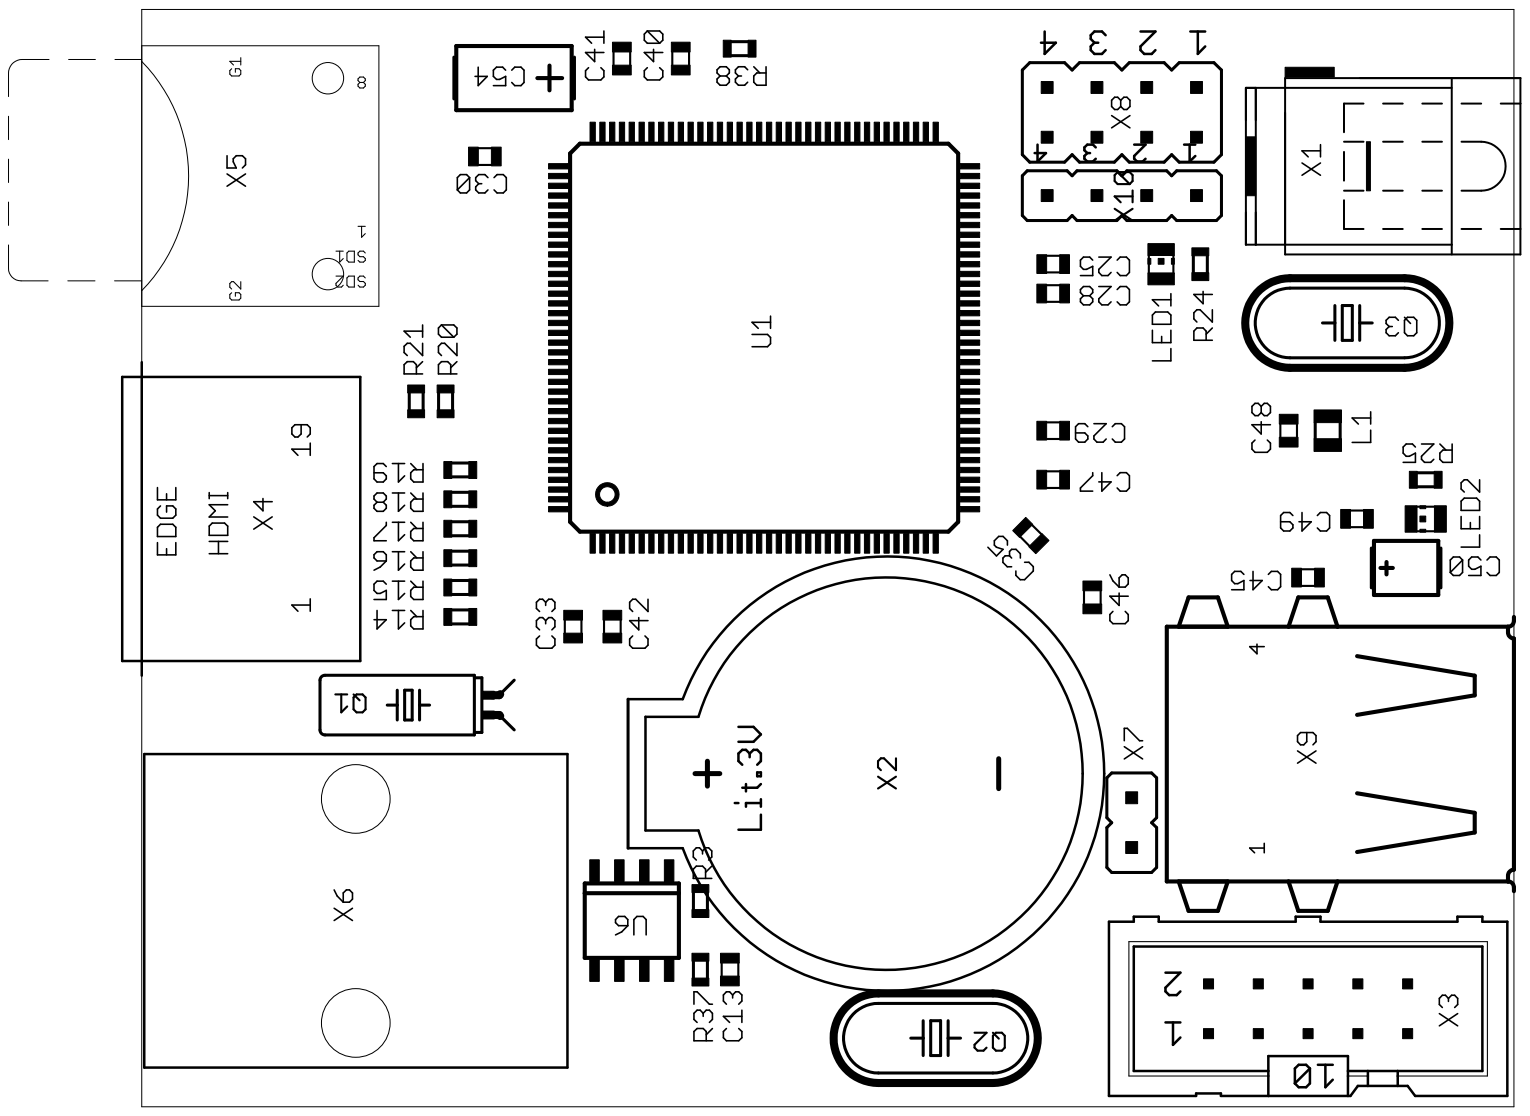
[picture p67: page 4]

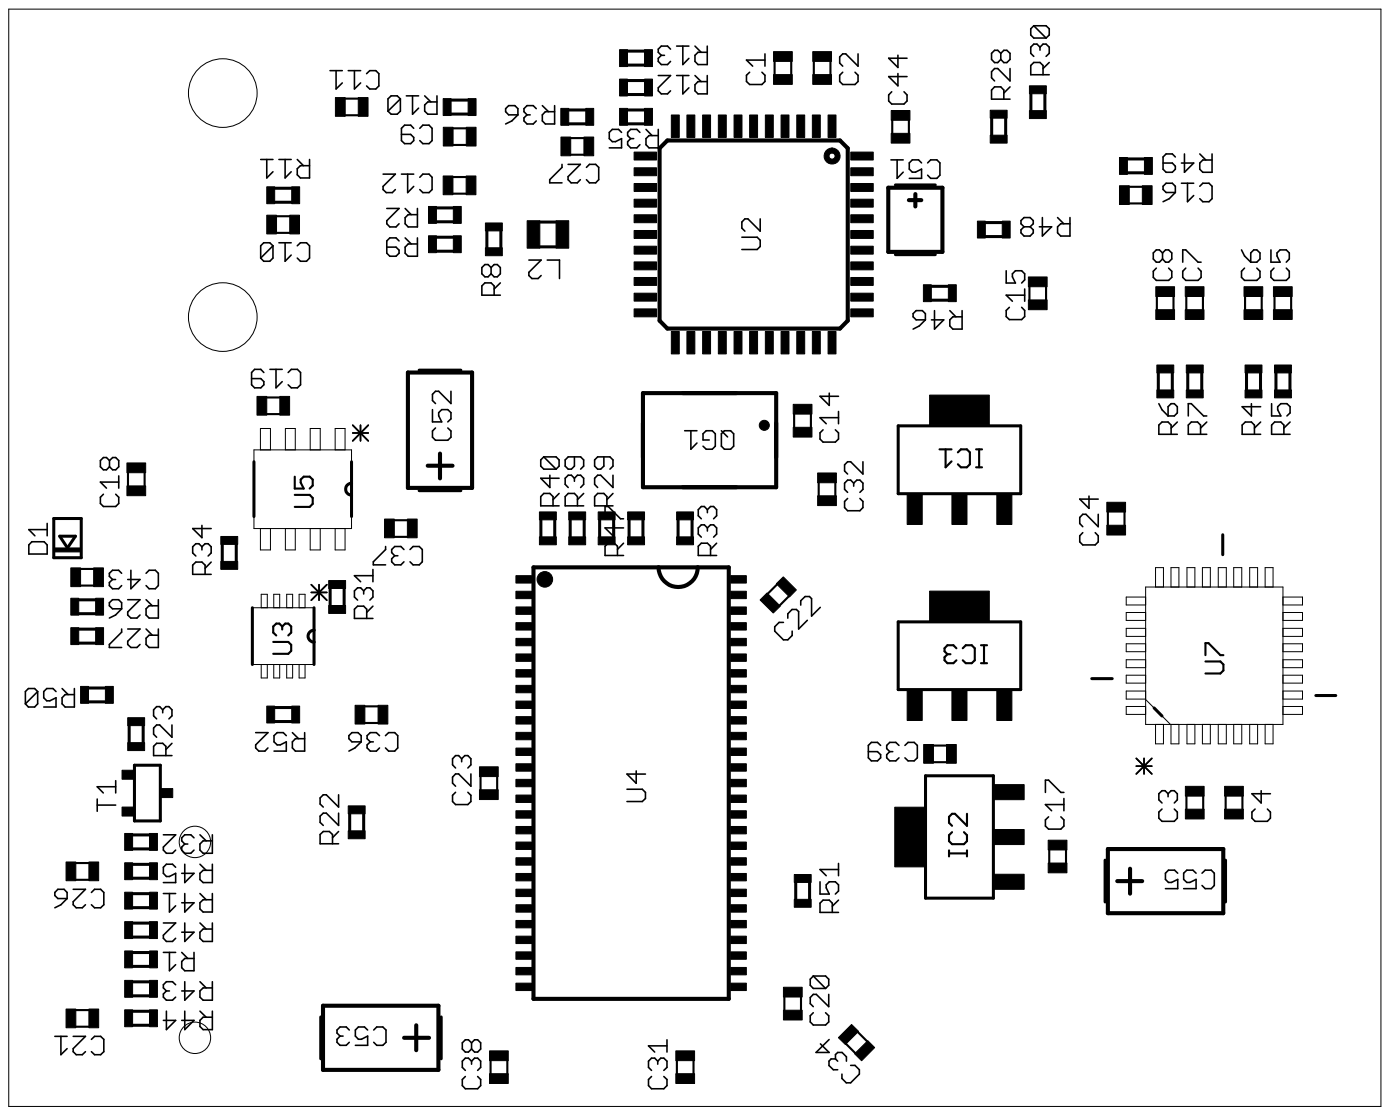
[picture p68: page 5]
