mvvproject/ReVerSE-U16/u16_board/u16_board_rev_a/manuals/u16_sch_rev_a.pdf

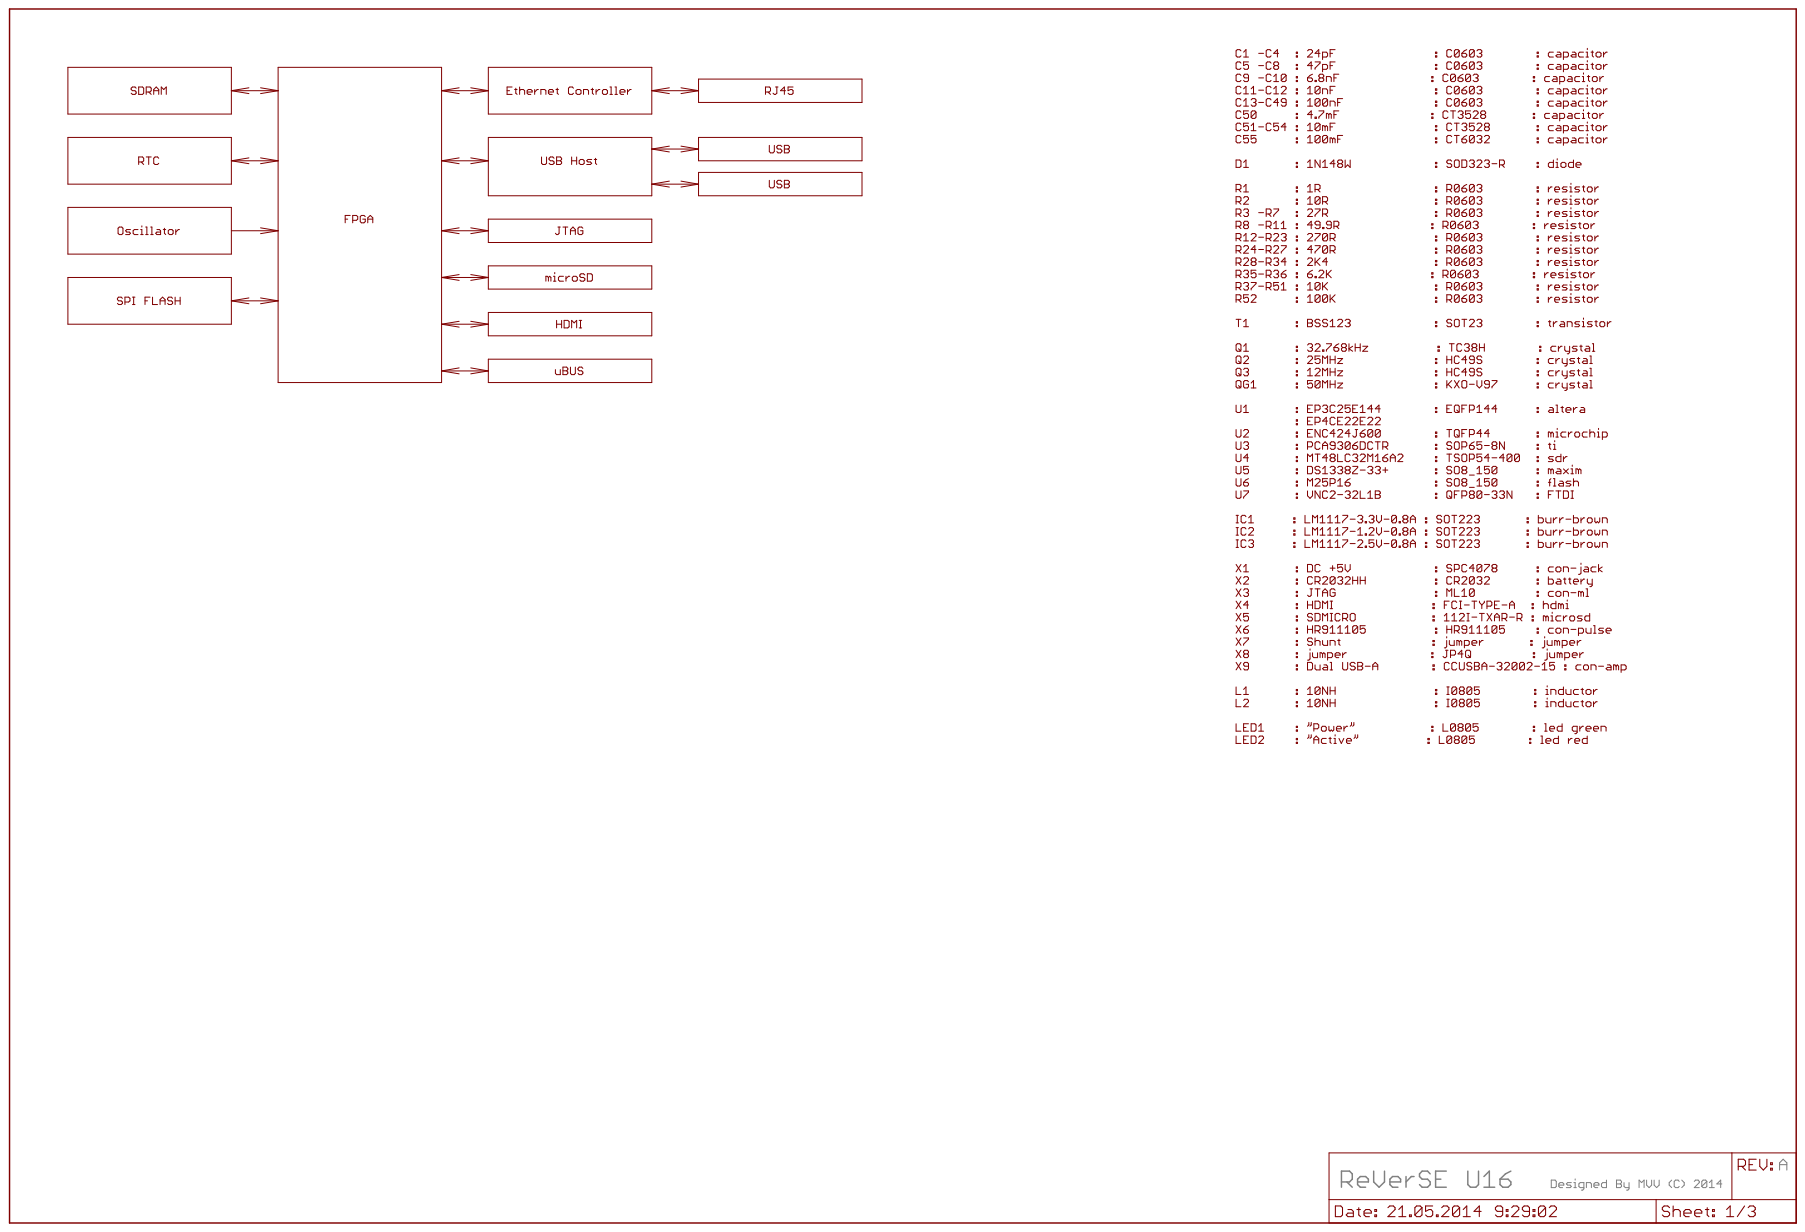
[picture p69: page 1]

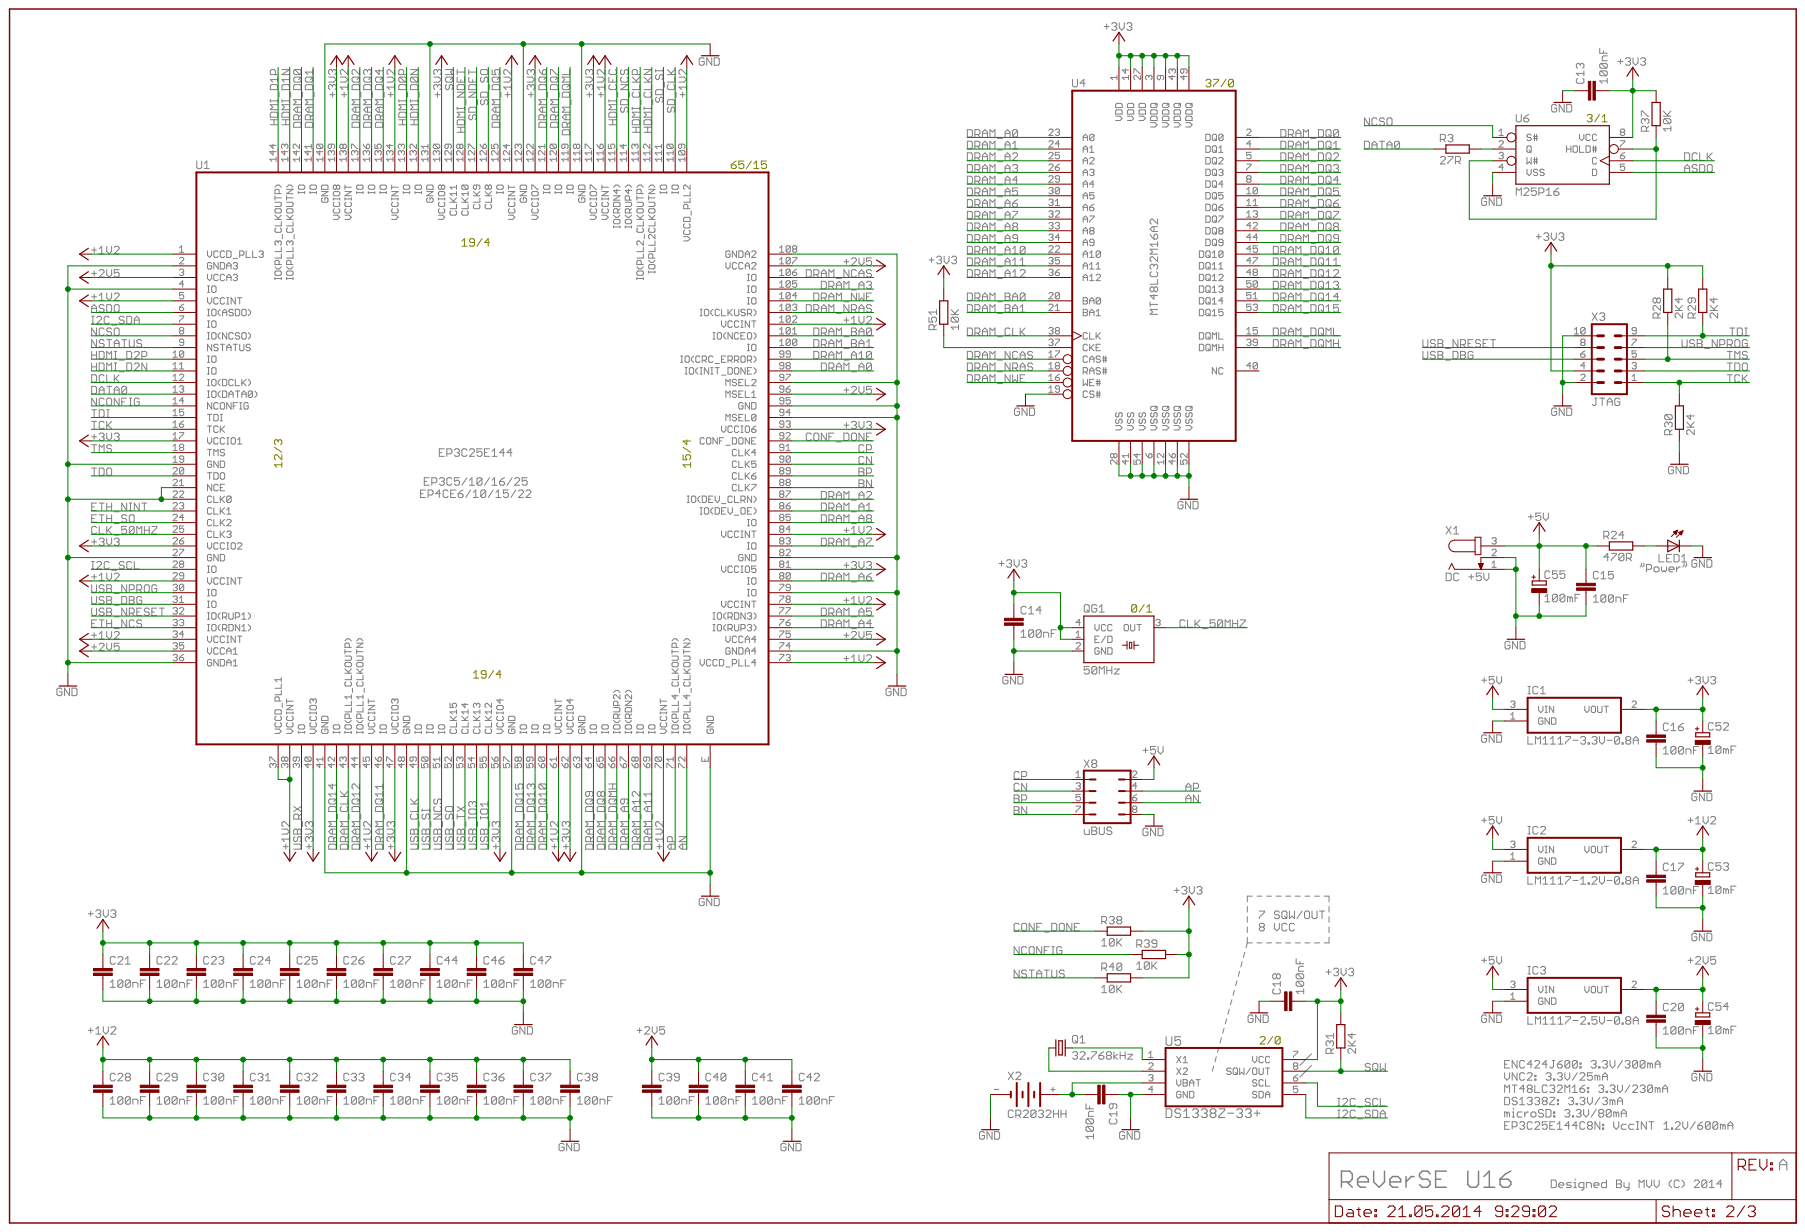
[picture p70: page 2]

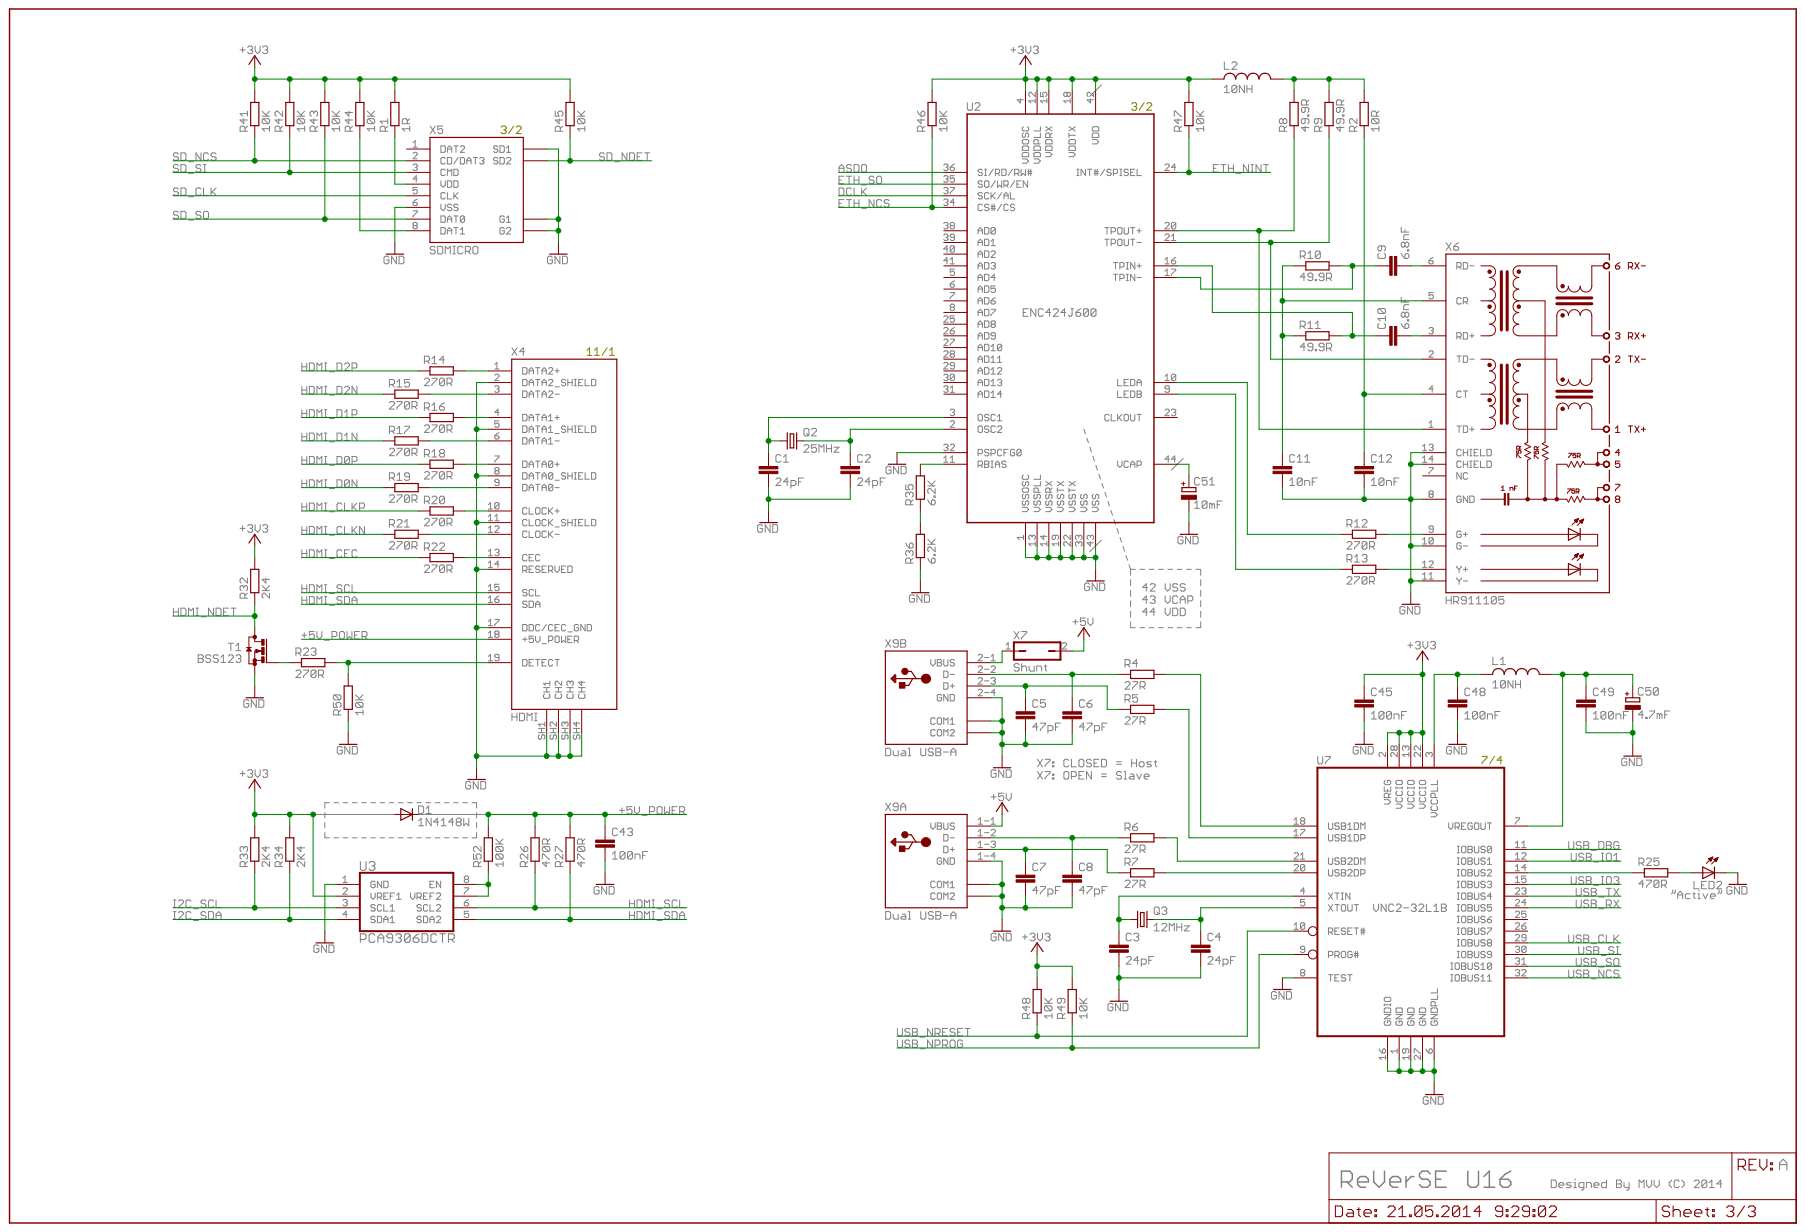
[picture p71: page 3]

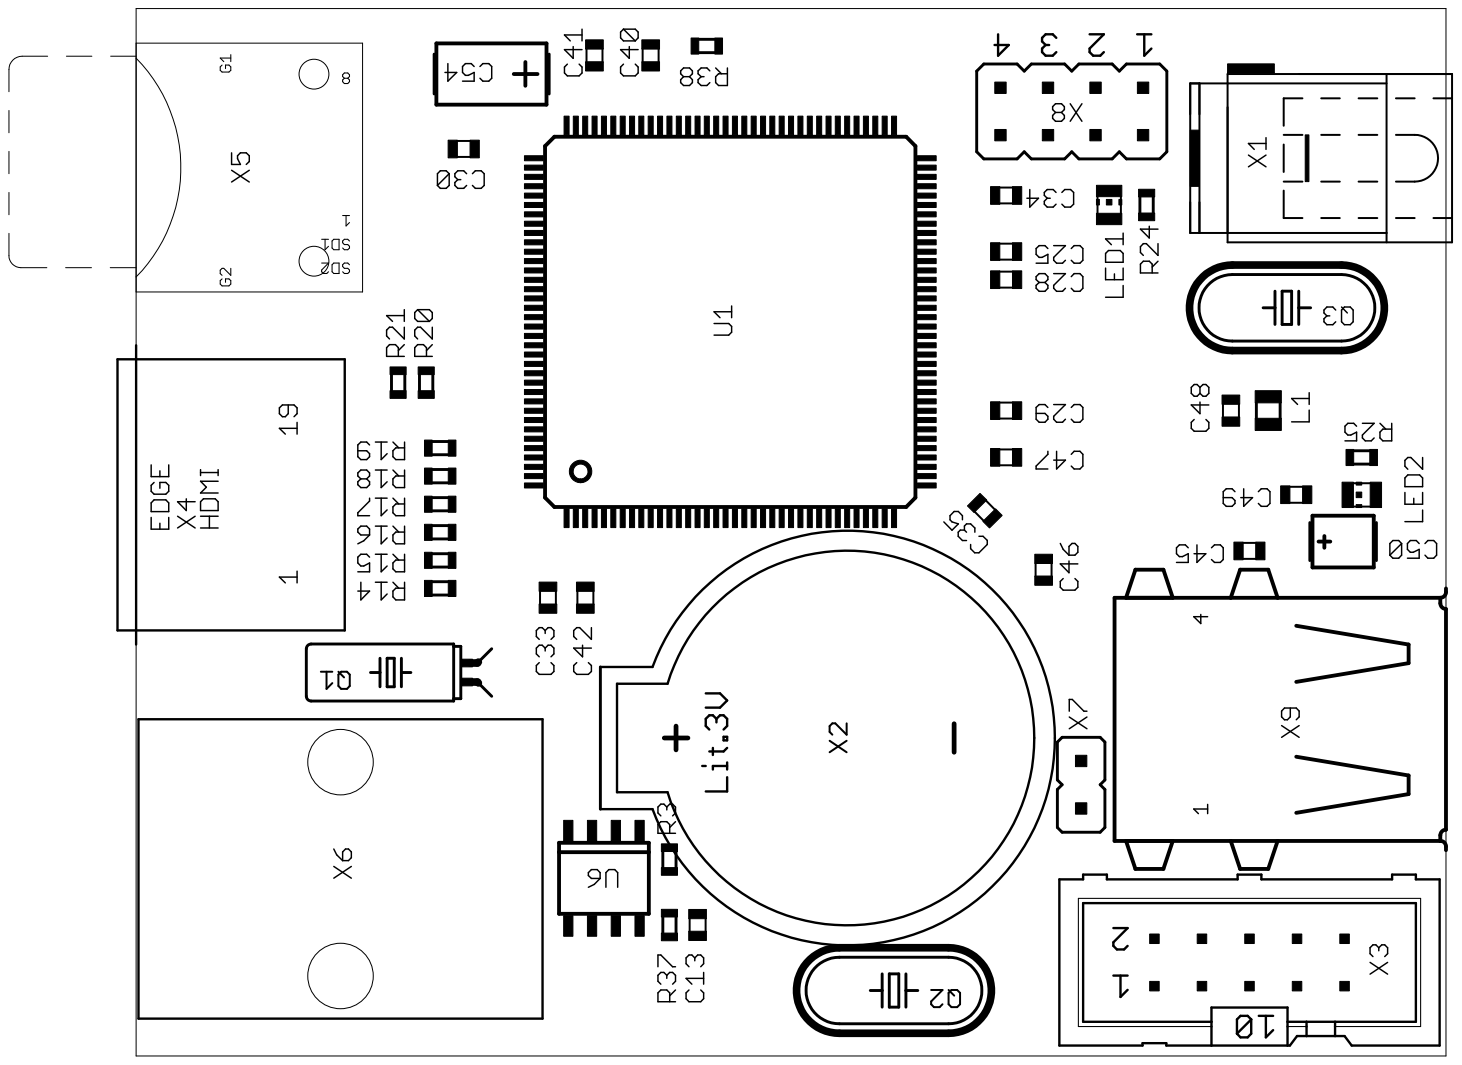
[picture p72: page 4]

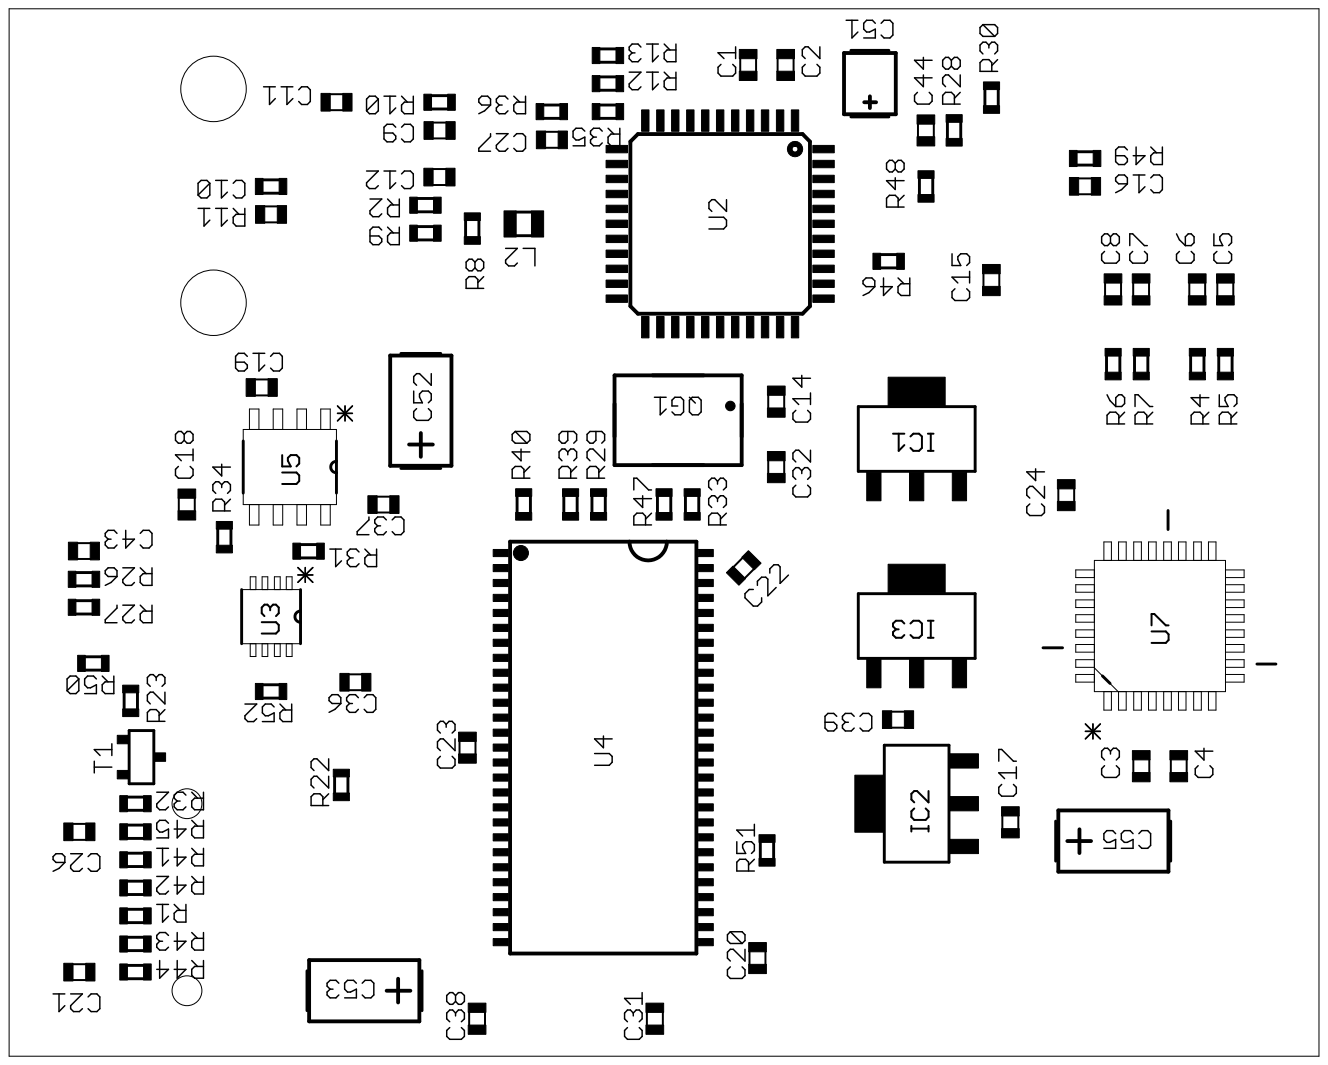
[picture p73: page 5]
