mvvproject/ReVerSE-U16/u16_board/u16_board_rev_b/manuals/u16_sch_rev_b.pdf

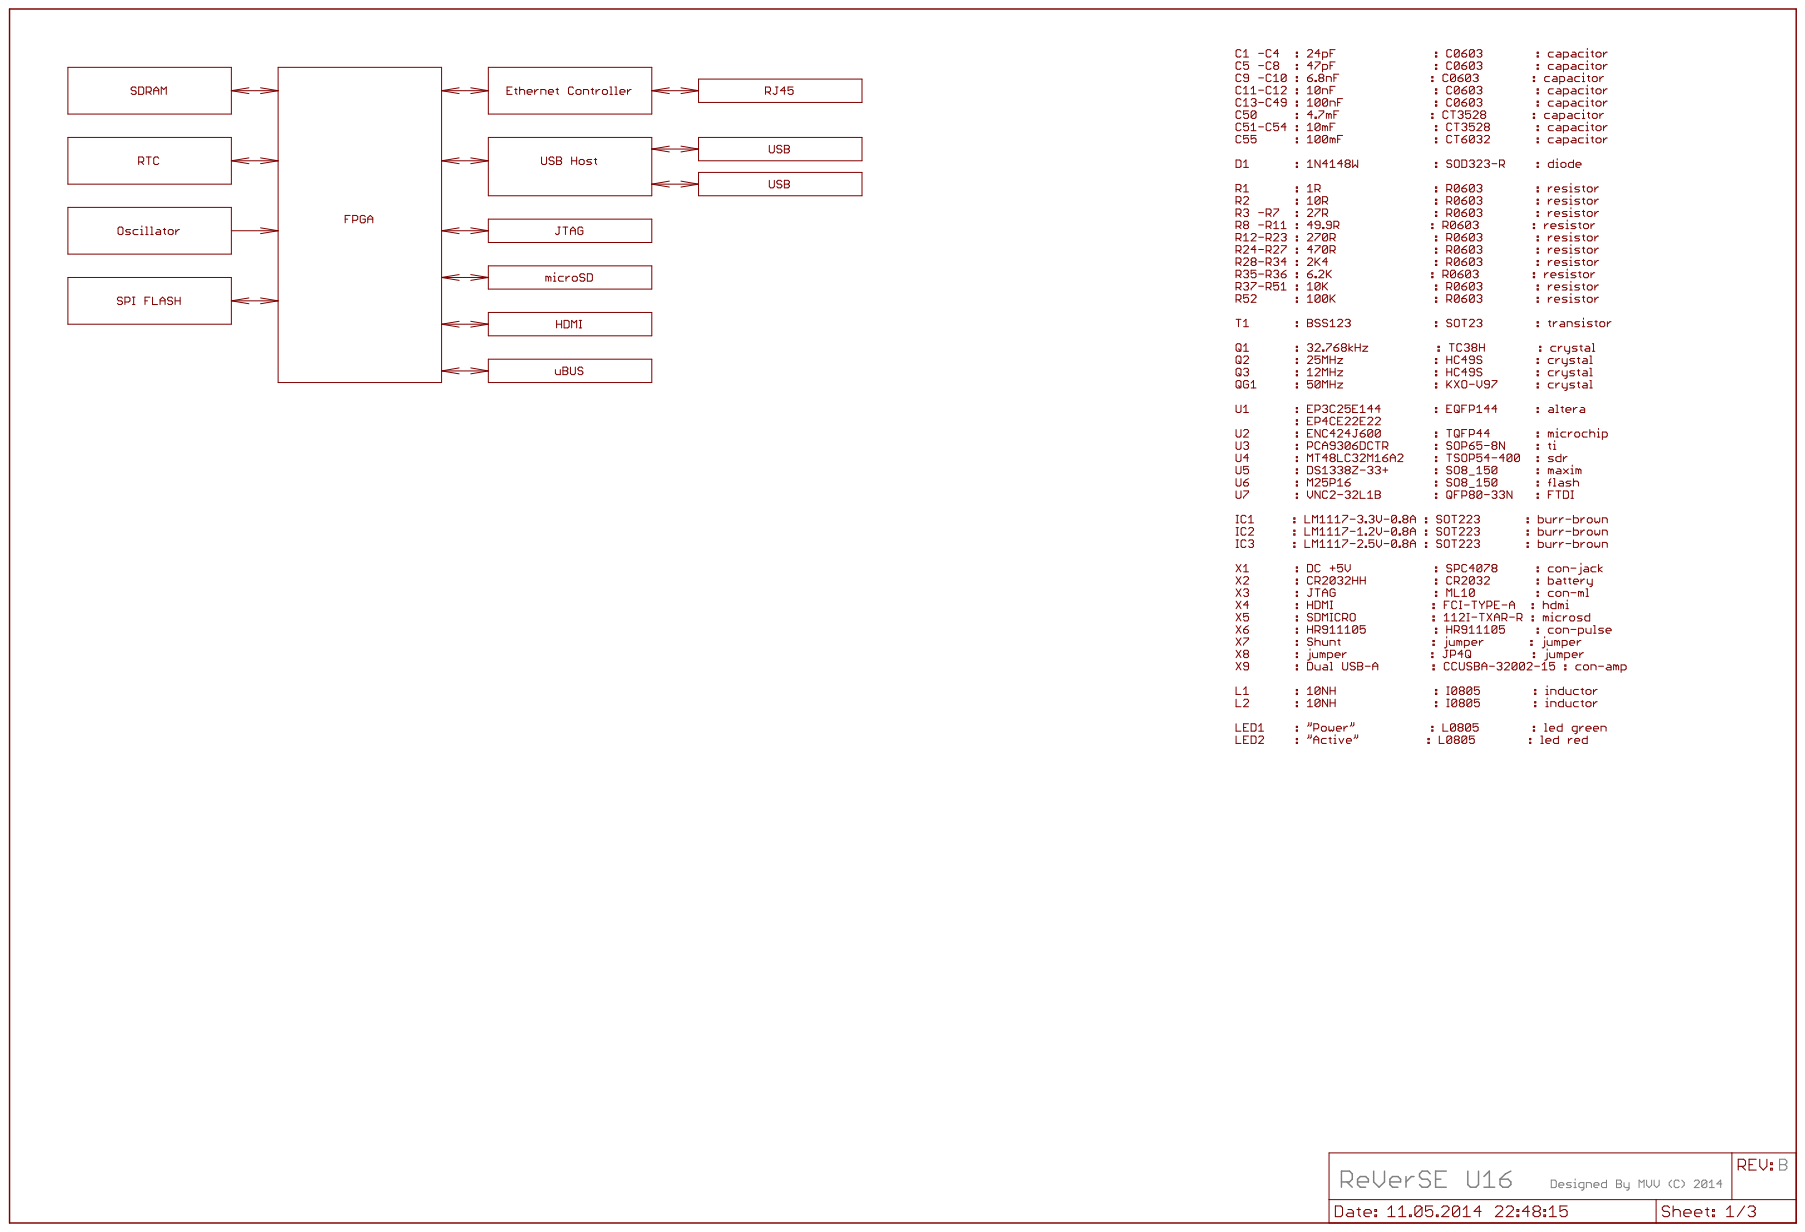
[picture p74: page 1]

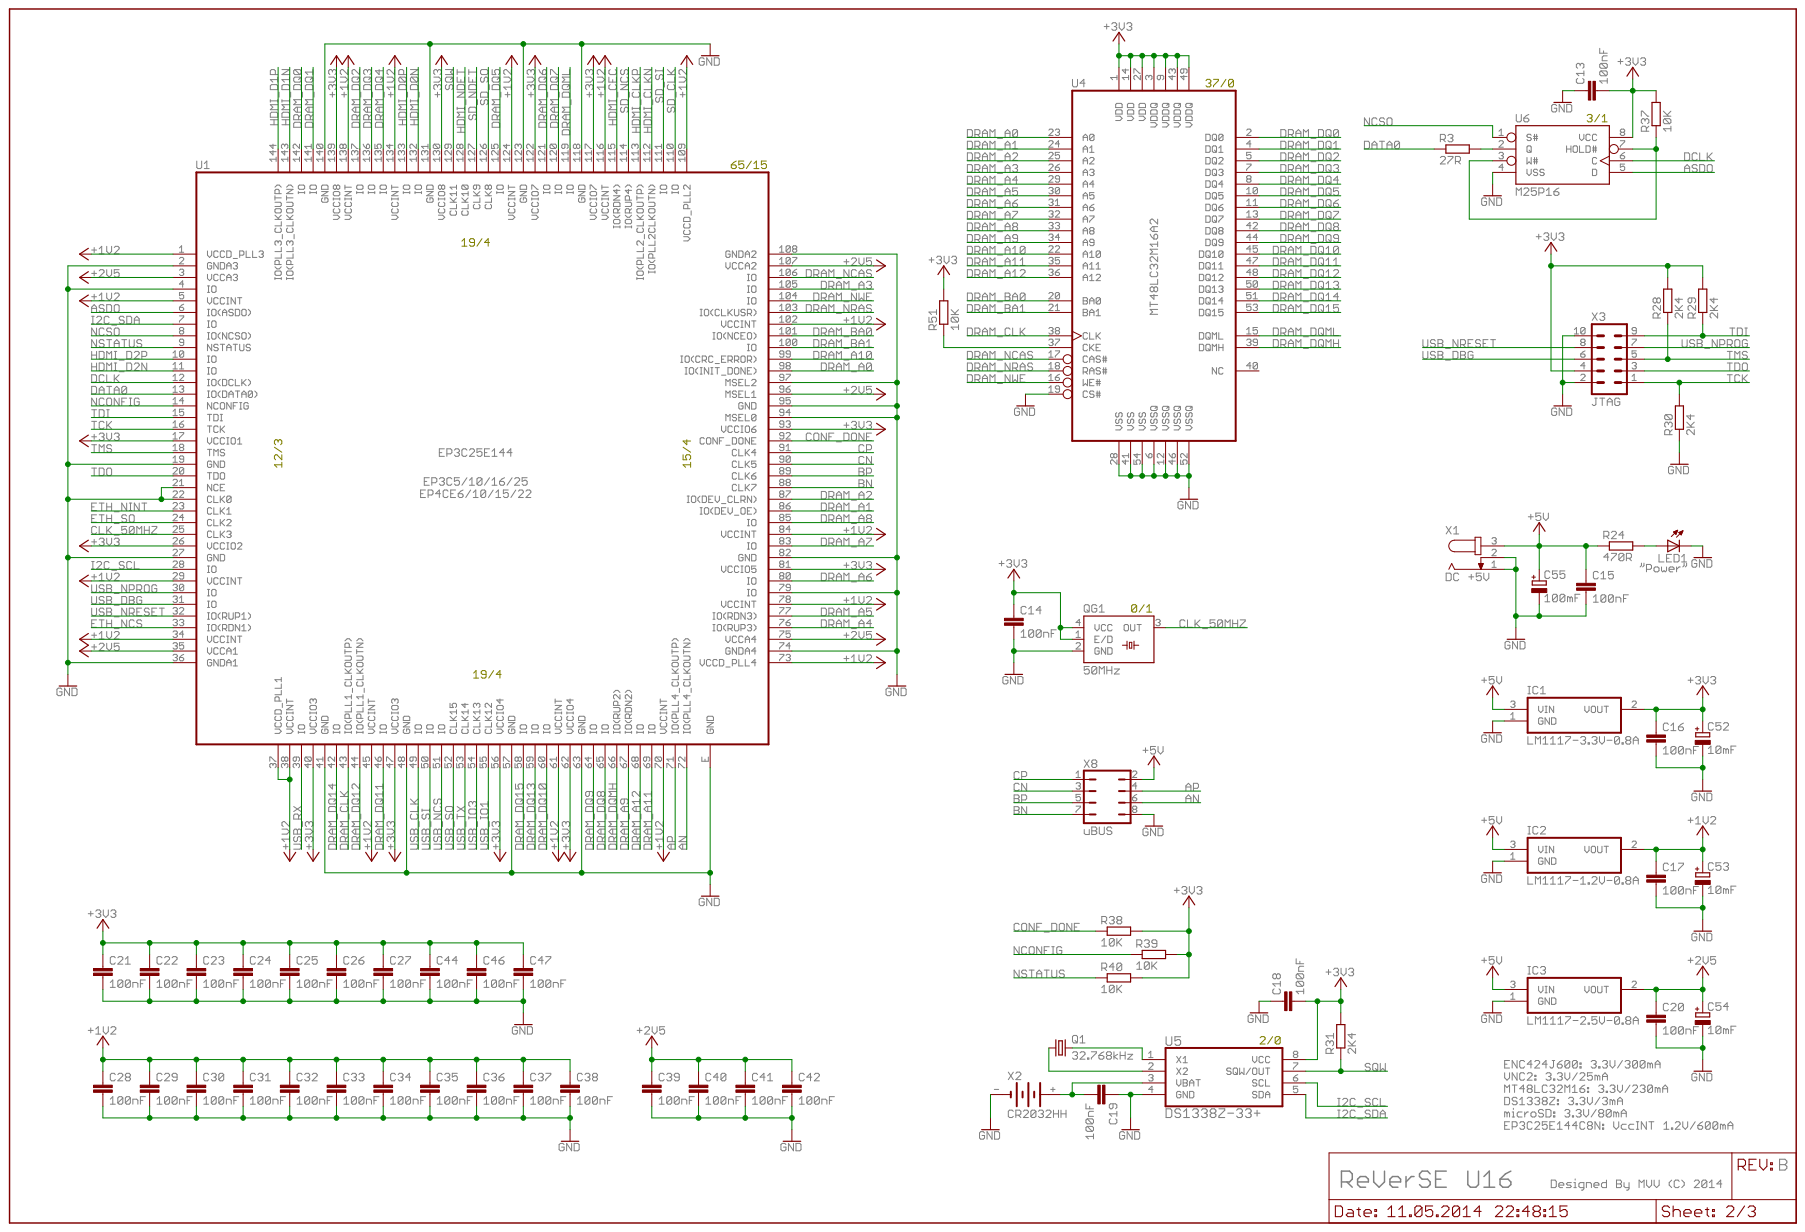
[picture p75: page 2]

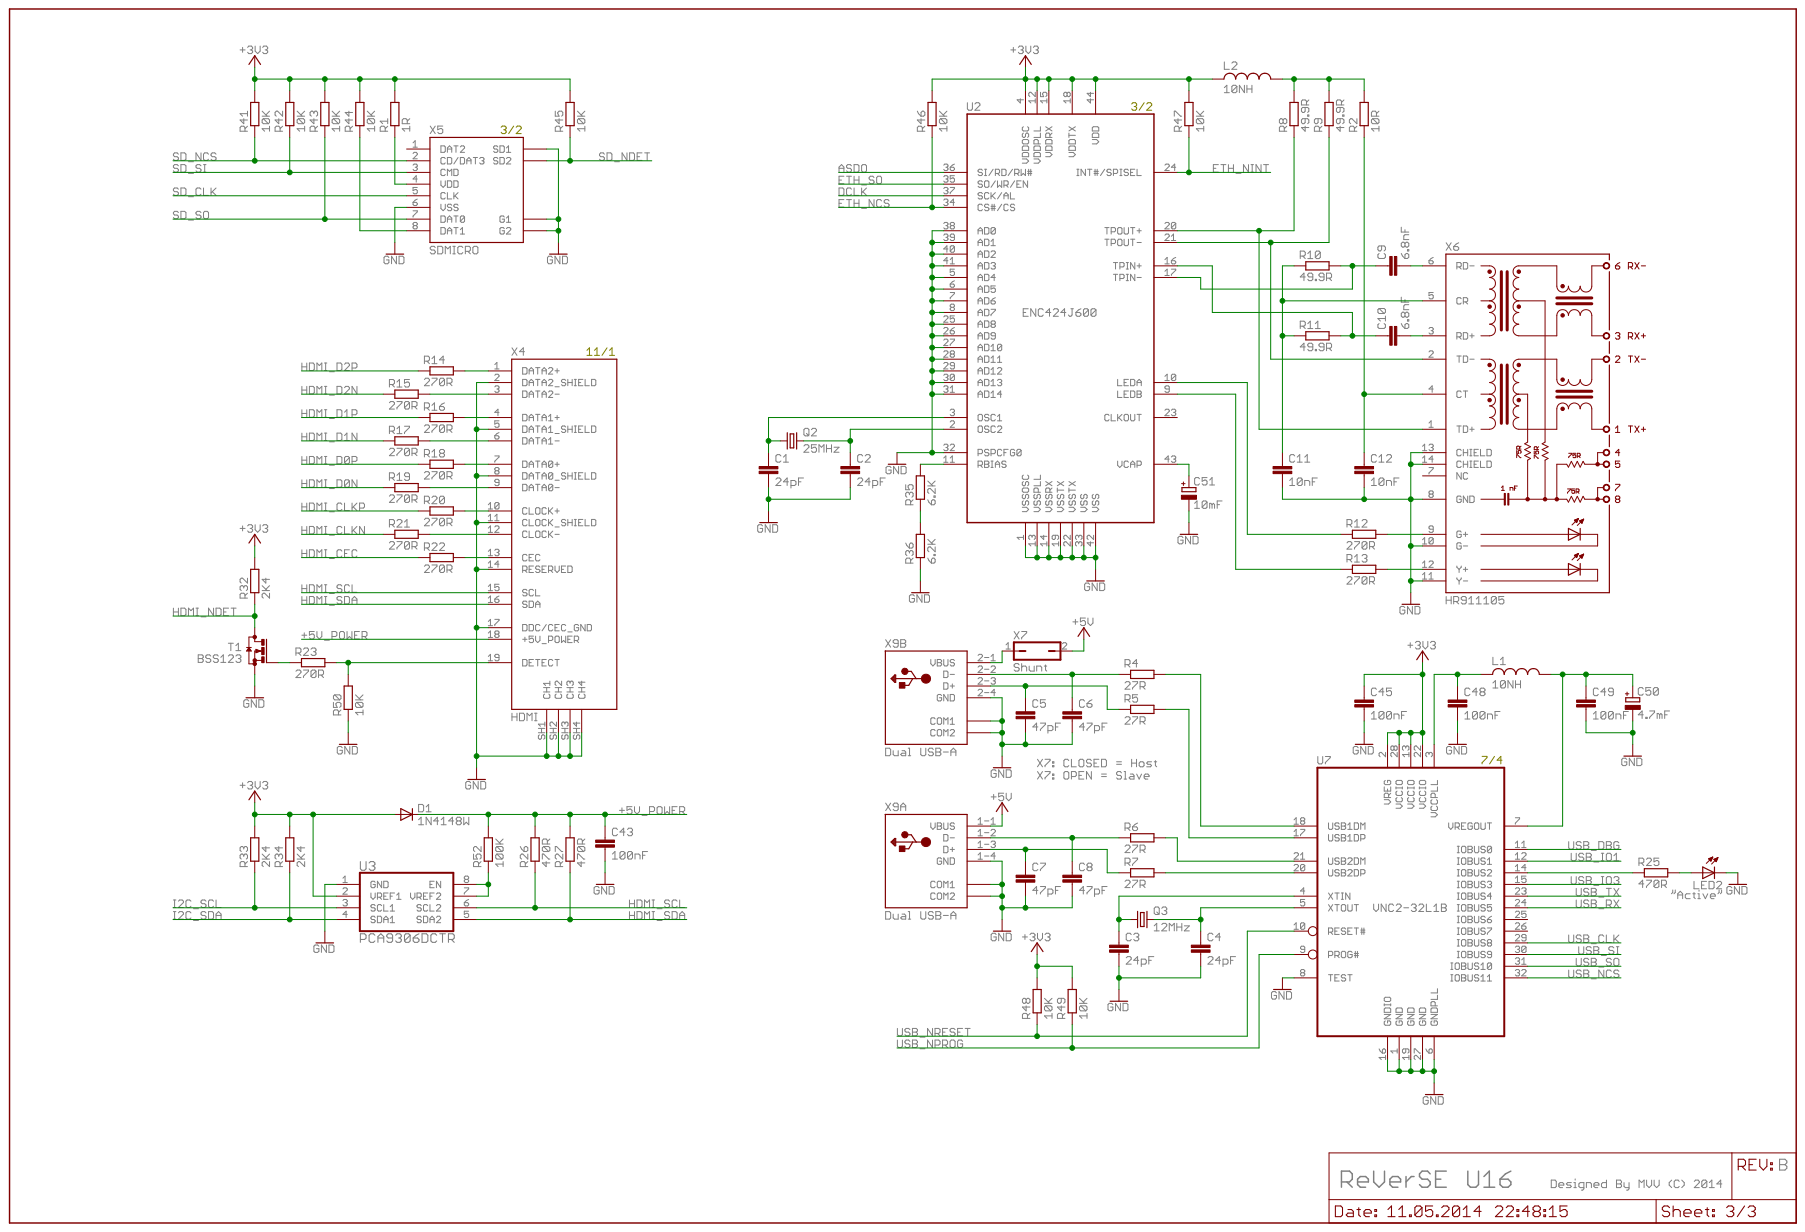
[picture p76: page 3]

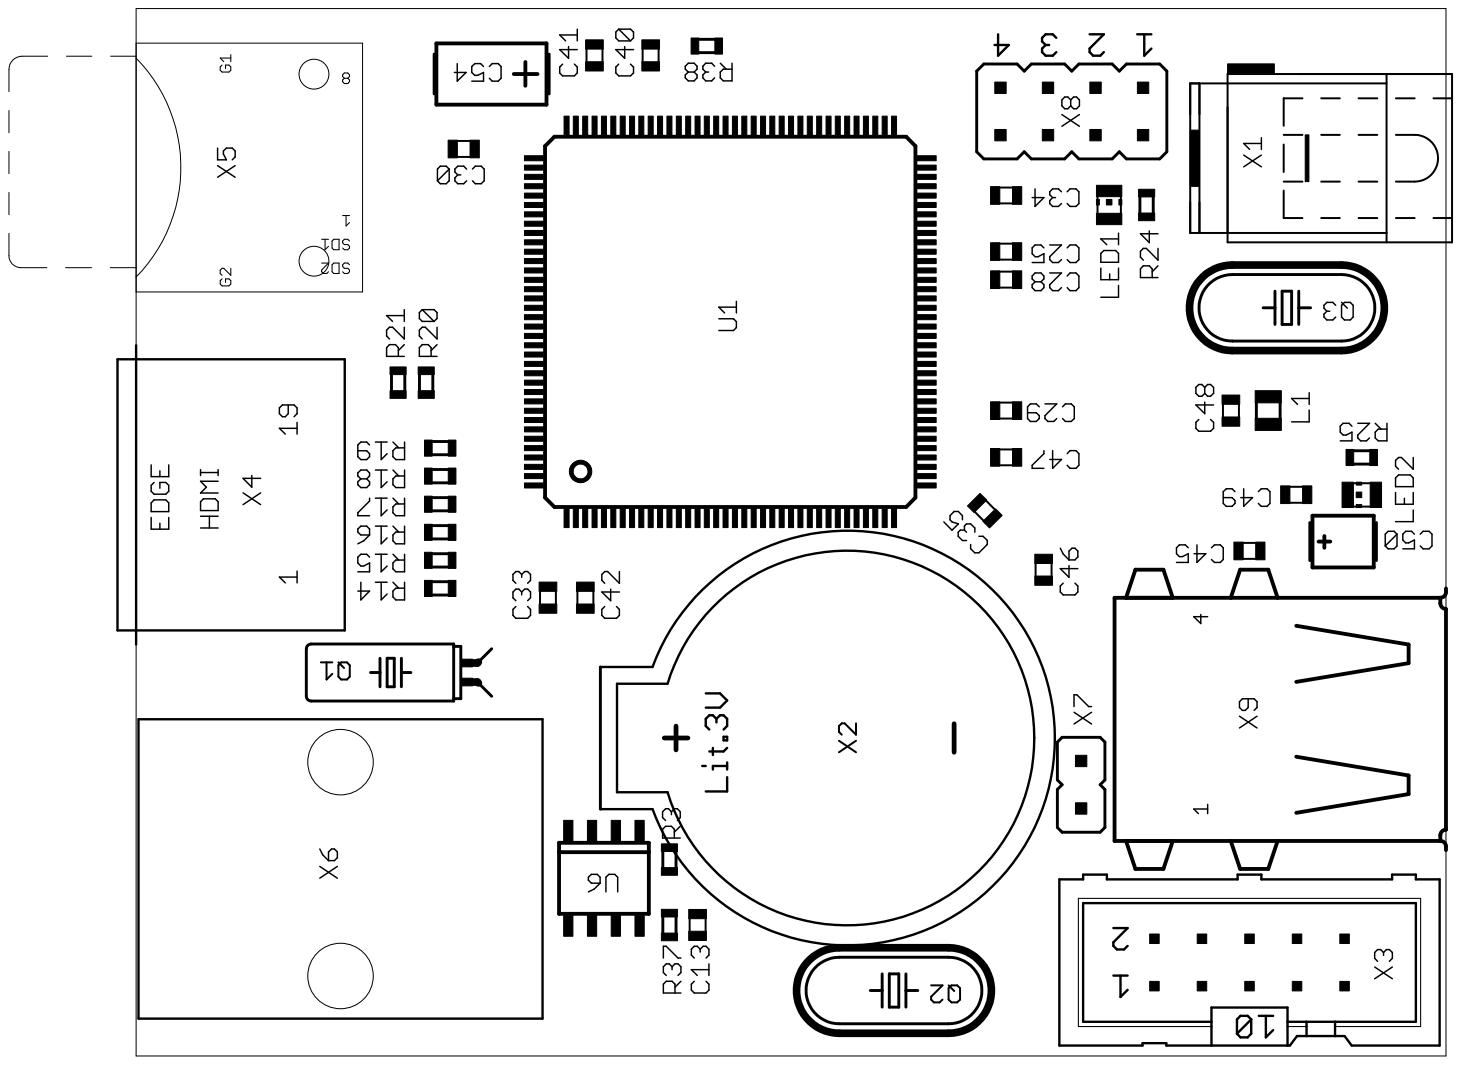
[picture p77: page 4]

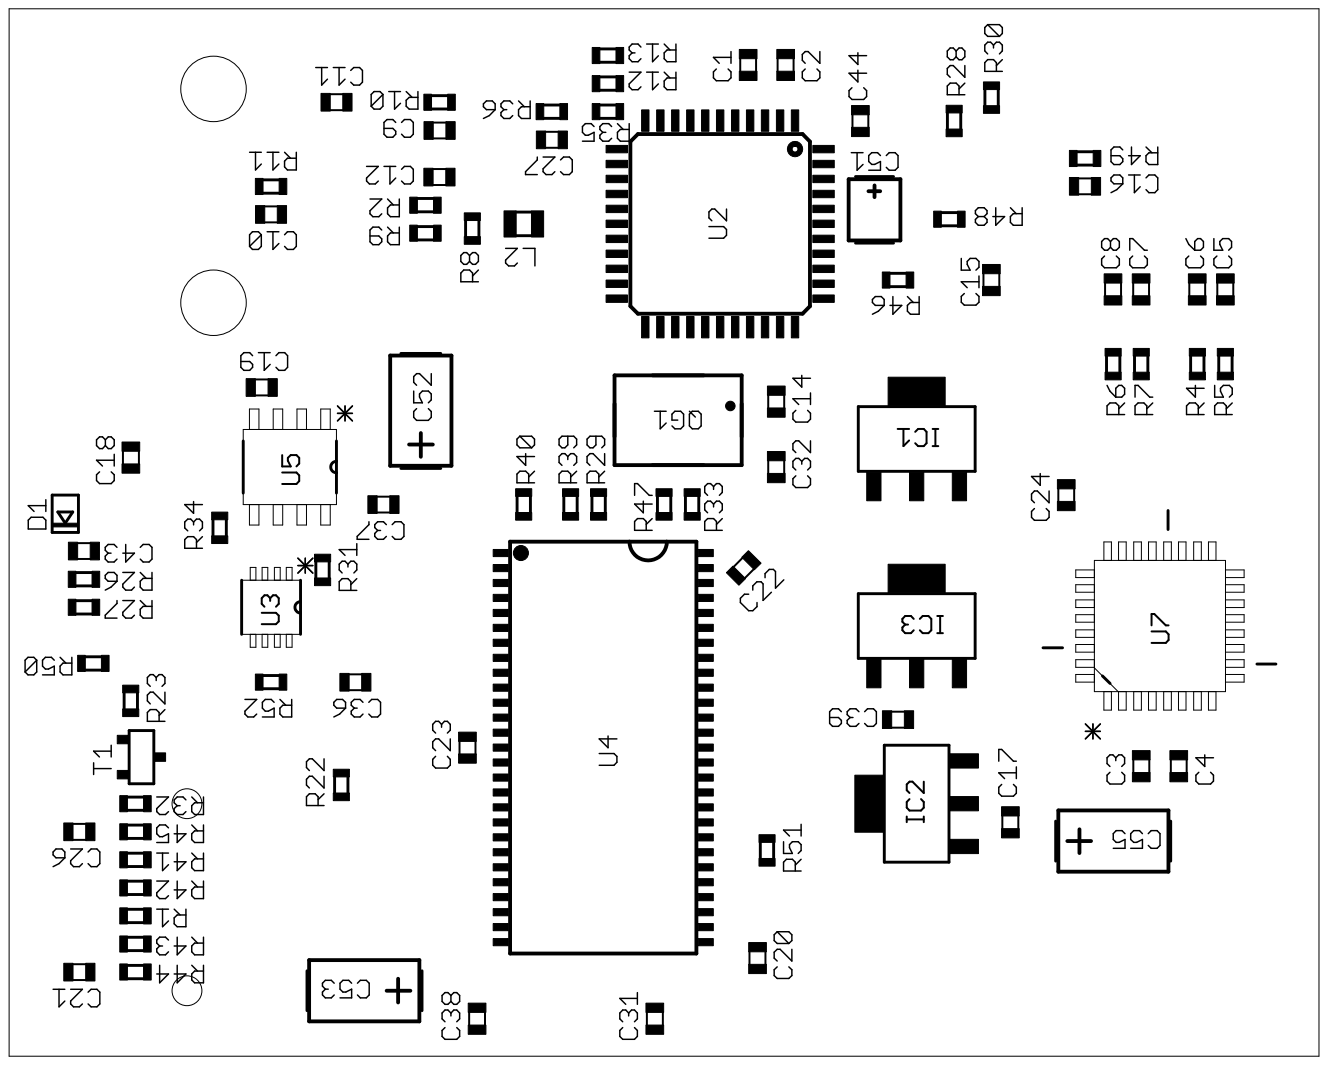
[picture p78: page 5]
