mvvproject/ReVerSE-U16/u16_board/modules/ubus/ubus_rev_b.brd

## EAGLE design u16_board/modules/ubus/ubus_rev_b.brd (2019-04-23)

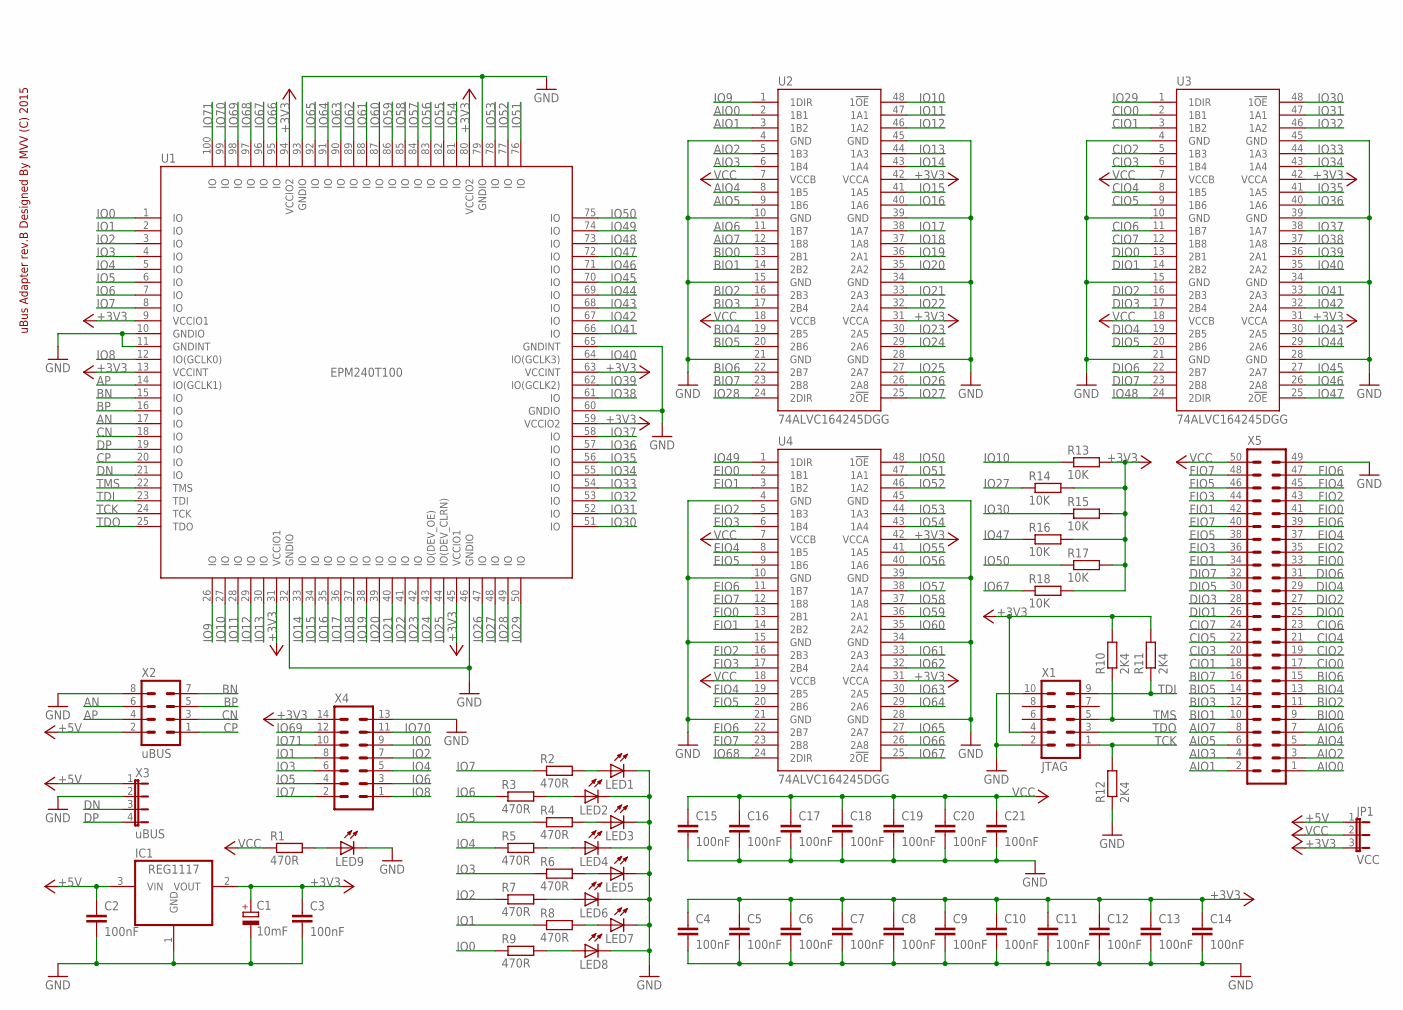
[picture p79: schematic ubus_rev_b.sch]

Parts:
C1: 10mF; CT6032
C2, C3, C4, C5, C6, C7, C8, C9, C10, C11, C12, C13, C14, C15, C16, C17, C18, C19, C20, C21: 100nF; C0805
IC1: REG1117; SOT223
JP1: VCC; JP2
LED1, LED2, LED3, LED4, LED5, LED6, LED7, LED8, LED9: LEDCHIPLED_0805; CHIPLED_0805
R1, R2, R3, R4, R5, R6, R7, R8, R9: 470R; R0805
R10, R11, R12: 2K4; R0805
R13, R14, R15, R16, R17, R18: 10K; R0805
U1: EPM240T100; TQFP100
U2, U3, U4: 74ALVC164245DGG; TSSOP48DGG
X1: JTAG; ML10
X2: uBUS; MA04-2
X3: uBUS; JP4
X4: ML14
X5: ML50

Connections:
+3V3: C1.+, C3.1, C4.1, C5.1, C6.1, C7.1, C8.1, C9.1, C10.1, C11.1, C12.1, C13.1, C14.1, IC1.2 (VOUT), JP1.3, R10.2, R11.2, R13.2, R14.2, R15.2, R16.2, R17.2, R18.2, U1.9 (VCCIO1), U1.13 (VCCINT), U1.31 (VCCIO1), U1.45 (VCCIO1), U1.59 (VCCIO2), U1.63 (VCCINT), U1.80 (VCCIO2), U1.94 (VCCIO2), U2.31 (VCCA), U2.42 (VCCA), U3.31 (VCCA), U3.42 (VCCA), U4.31 (VCCA), U4.42 (VCCA), X1.4, X4.14
+5V: C2.1, IC1.3 (VIN), JP1.1, X2.2, X3.1
AIO0: U2.2 (1B1), X5.1
AIO1: U2.3 (1B2), X5.2
AIO2: U2.5 (1B3), X5.3
AIO3: U2.6 (1B4), X5.4
AIO4: U2.8 (1B5), X5.5
AIO5: U2.9 (1B6), X5.6
AIO6: U2.11 (1B7), X5.7
AIO7: U2.12 (1B8), X5.8
AN: U1.17 (IO), X2.6
AP: U1.14 (IO(GCLK1)), X2.4
BIO0: U2.13 (2B1), X5.9
BIO1: U2.14 (2B2), X5.10
BIO2: U2.16 (2B3), X5.11
BIO3: U2.17 (2B4), X5.12
BIO4: U2.19 (2B5), X5.13
BIO5: U2.20 (2B6), X5.14
BIO6: U2.22 (2B7), X5.15
BIO7: U2.23 (2B8), X5.16
BN: U1.15 (IO), X2.7
BP: U1.16 (IO), X2.5
CIO0: U3.2 (1B1), X5.17
CIO1: U3.3 (1B2), X5.18
CIO2: U3.5 (1B3), X5.19
CIO3: U3.6 (1B4), X5.20
CIO4: U3.8 (1B5), X5.21
CIO5: U3.9 (1B6), X5.22
CIO6: U3.11 (1B7), X5.23
CIO7: U3.12 (1B8), X5.24
CN: U1.18 (IO), X2.3
CP: U1.20 (IO), X2.1
DIO0: U3.13 (2B1), X5.25
DIO1: U3.14 (2B2), X5.26
DIO2: U3.16 (2B3), X5.27
DIO3: U3.17 (2B4), X5.28
DIO4: U3.19 (2B5), X5.29
DIO5: U3.20 (2B6), X5.30
DIO6: U3.22 (2B7), X5.31
DIO7: U3.23 (2B8), X5.32
DN: U1.21 (IO), X3.3
DP: U1.19 (IO), X3.4
EIO0: U4.2 (1B1), X5.33
EIO1: U4.3 (1B2), X5.34
EIO2: U4.5 (1B3), X5.35
EIO3: U4.6 (1B4), X5.36
EIO4: U4.8 (1B5), X5.37
EIO5: U4.9 (1B6), X5.38
EIO6: U4.11 (1B7), X5.39
EIO7: U4.12 (1B8), X5.40
FIO0: U4.13 (2B1), X5.41
FIO1: U4.14 (2B2), X5.42
FIO2: U4.16 (2B3), X5.43
FIO3: U4.17 (2B4), X5.44
FIO4: U4.19 (2B5), X5.45
FIO5: U4.20 (2B6), X5.46
FIO6: U4.22 (2B7), X5.47
FIO7: U4.23 (2B8), X5.48
GND: C1.-, C2.2, C3.2, C4.2, C5.2, C6.2, C7.2, C8.2, C9.2, C10.2, C11.2, C12.2, C13.2, C14.2, C15.2, C16.2, C17.2, C18.2, C19.2, C20.2, C21.2, IC1.1 (GND), LED1.C, LED2.C, LED3.C, LED4.C, LED5.C, LED6.C, LED7.C, LED8.C, LED9.C, R12.1, U1.10 (GNDIO), U1.11 (GNDINT), U1.32 (GNDIO), U1.46 (GNDIO), U1.60 (GNDIO), U1.65 (GNDINT), U1.79 (GNDIO), U1.93 (GNDIO), U2.4 (GND), U2.10 (GND), U2.15 (GND), U2.21 (GND), U2.28 (GND), U2.34 (GND), U2.39 (GND), U2.45 (GND), U3.4 (GND), U3.10 (GND), U3.15 (GND), U3.21 (GND), U3.28 (GND), U3.34 (GND), U3.39 (GND), U3.45 (GND), U4.4 (GND), U4.10 (GND), U4.15 (GND), U4.21 (GND), U4.28 (GND), U4.34 (GND), U4.39 (GND), U4.45 (GND), X1.2, X1.10, X2.8, X3.2, X4.13, X5.49
IO0: R9.1, U1.1 (IO), X4.9
IO1: R8.1, U1.2 (IO), X4.8
IO2: R7.1, U1.3 (IO), X4.7
IO3: R6.1, U1.4 (IO), X4.6
IO4: R5.1, U1.5 (IO), X4.5
IO5: R4.1, U1.6 (IO), X4.4
IO6: R3.1, U1.7 (IO), X4.3
IO7: R2.1, U1.8 (IO), X4.2
IO8: U1.12 (IO(GCLK0)), X4.1
IO9: U1.26 (IO), U2.1 (1DIR)
IO10: R13.1, U1.27 (IO), U2.48 (1!OE)
IO11: U1.28 (IO), U2.47 (1A1)
IO12: U1.29 (IO), U2.46 (1A2)
IO13: U1.30 (IO), U2.44 (1A3)
IO14: U1.33 (IO), U2.43 (1A4)
IO15: U1.34 (IO), U2.41 (1A5)
IO16: U1.35 (IO), U2.40 (1A6)
IO17: U1.36 (IO), U2.38 (1A7)
IO18: U1.37 (IO), U2.37 (1A8)
IO19: U1.38 (IO), U2.36 (2A1)
IO20: U1.39 (IO), U2.35 (2A2)
IO21: U1.40 (IO), U2.33 (2A3)
IO22: U1.41 (IO), U2.32 (2A4)
IO23: U1.42 (IO), U2.30 (2A5)
IO24: U1.43 (IO(DEV_OE)), U2.29 (2A6)
IO25: U1.44 (IO(DEV_CLRN)), U2.27 (2A7)
IO26: U1.47 (IO), U2.26 (2A8)
IO27: R14.1, U1.48 (IO), U2.25 (2!OE)
IO28: U1.49 (IO), U2.24 (2DIR)
IO29: U1.50 (IO), U3.1 (1DIR)
IO30: R15.1, U1.51 (IO), U3.48 (1!OE)
IO31: U1.52 (IO), U3.47 (1A1)
IO32: U1.53 (IO), U3.46 (1A2)
IO33: U1.54 (IO), U3.44 (1A3)
IO34: U1.55 (IO), U3.43 (1A4)
IO35: U1.56 (IO), U3.41 (1A5)
IO36: U1.57 (IO), U3.40 (1A6)
IO37: U1.58 (IO), U3.38 (1A7)
IO38: U1.61 (IO), U3.37 (1A8)
IO39: U1.62 (IO(GCLK2)), U3.36 (2A1)
IO40: U1.64 (IO(GCLK3)), U3.35 (2A2)
IO41: U1.66 (IO), U3.33 (2A3)
IO42: U1.67 (IO), U3.32 (2A4)
IO43: U1.68 (IO), U3.30 (2A5)
IO44: U1.69 (IO), U3.29 (2A6)
IO45: U1.70 (IO), U3.27 (2A7)
IO46: U1.71 (IO), U3.26 (2A8)
IO47: R16.1, U1.72 (IO), U3.25 (2!OE)
IO48: U1.73 (IO), U3.24 (2DIR)
IO49: U1.74 (IO), U4.1 (1DIR)
IO50: R17.1, U1.75 (IO), U4.48 (1!OE)
IO51: U1.76 (IO), U4.47 (1A1)
IO52: U1.77 (IO), U4.46 (1A2)
IO53: U1.78 (IO), U4.44 (1A3)
IO54: U1.81 (IO), U4.43 (1A4)
IO55: U1.82 (IO), U4.41 (1A5)
IO56: U1.83 (IO), U4.40 (1A6)
IO57: U1.84 (IO), U4.38 (1A7)
IO58: U1.85 (IO), U4.37 (1A8)
IO59: U1.86 (IO), U4.36 (2A1)
IO60: U1.87 (IO), U4.35 (2A2)
IO61: U1.88 (IO), U4.33 (2A3)
IO62: U1.89 (IO), U4.32 (2A4)
IO63: U1.90 (IO), U4.30 (2A5)
IO64: U1.91 (IO), U4.29 (2A6)
IO65: U1.92 (IO), U4.27 (2A7)
IO66: U1.95 (IO), U4.26 (2A8)
IO67: R18.1, U1.96 (IO), U4.25 (2!OE)
IO68: U1.97 (IO), U4.24 (2DIR)
IO69: U1.98 (IO), X4.12
IO70: U1.99 (IO), X4.11
IO71: U1.100 (IO), X4.10
unnamed: LED1.A, R2.2
unnamed: LED2.A, R3.2
unnamed: LED3.A, R4.2
unnamed: LED4.A, R5.2
unnamed: LED5.A, R6.2
unnamed: LED6.A, R7.2
unnamed: LED7.A, R8.2
unnamed: LED8.A, R9.2
unnamed: LED9.A, R1.2
TCK: R12.2, U1.24 (TCK), X1.1
TDI: R11.1, U1.23 (TDI), X1.9
TDO: U1.25 (TDO), X1.3
TMS: R10.1, U1.22 (TMS), X1.5
VCC: C15.1, C16.1, C17.1, C18.1, C19.1, C20.1, C21.1, JP1.2, R1.1, U2.7 (VCCB), U2.18 (VCCB), U3.7 (VCCB), U3.18 (VCCB), U4.7 (VCCB), U4.18 (VCCB), X5.50

Notes on the sheet:
uBus Adapter rev.B Designed By MVV (C) 2015

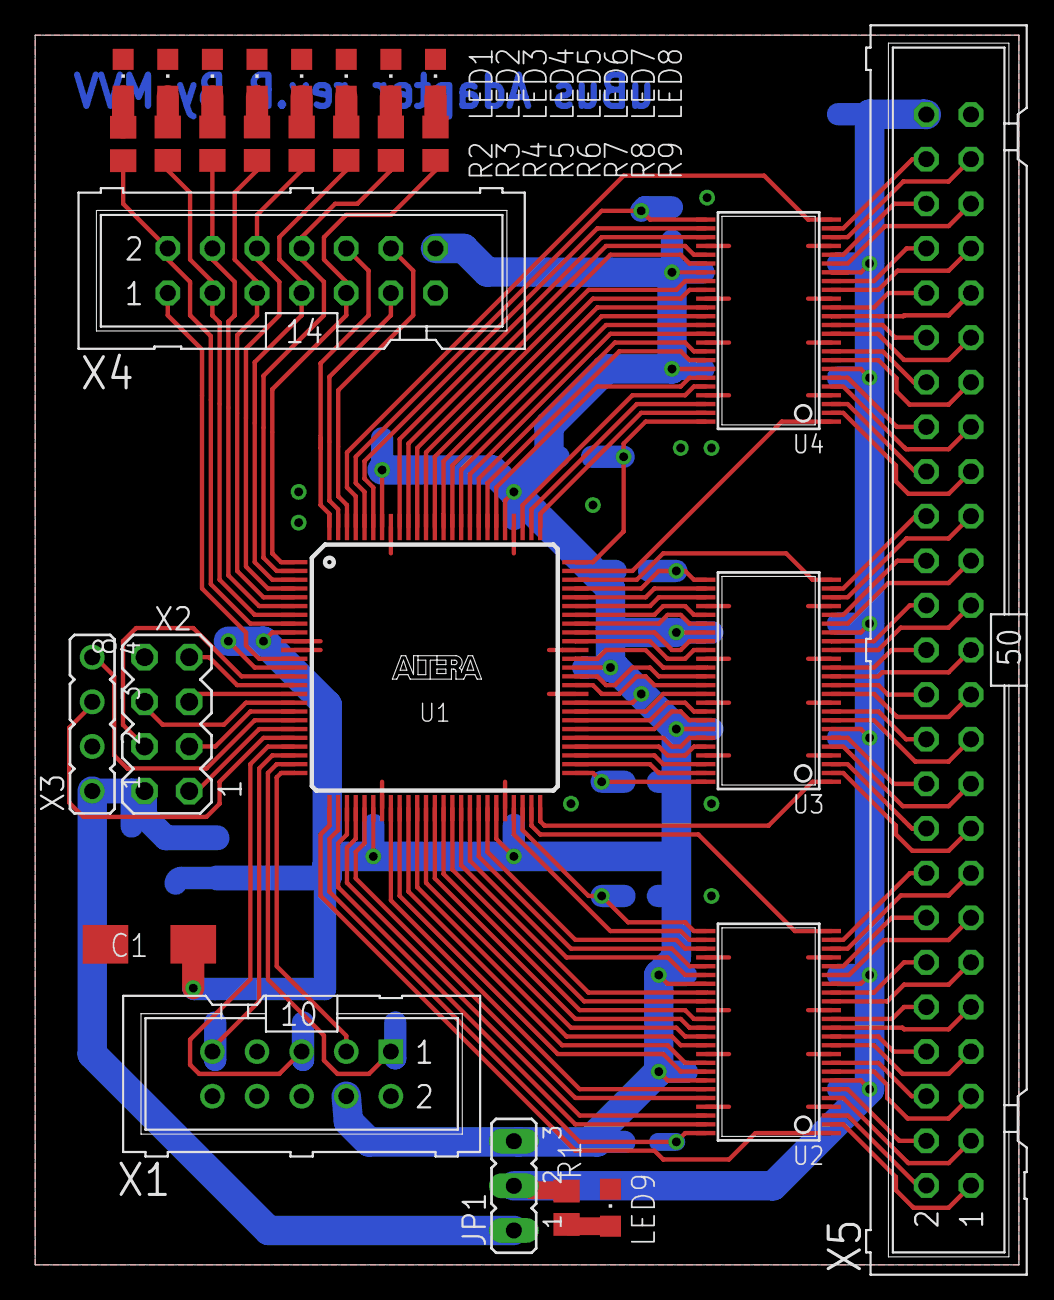
[picture p80: board ubus_rev_b.brd from above]

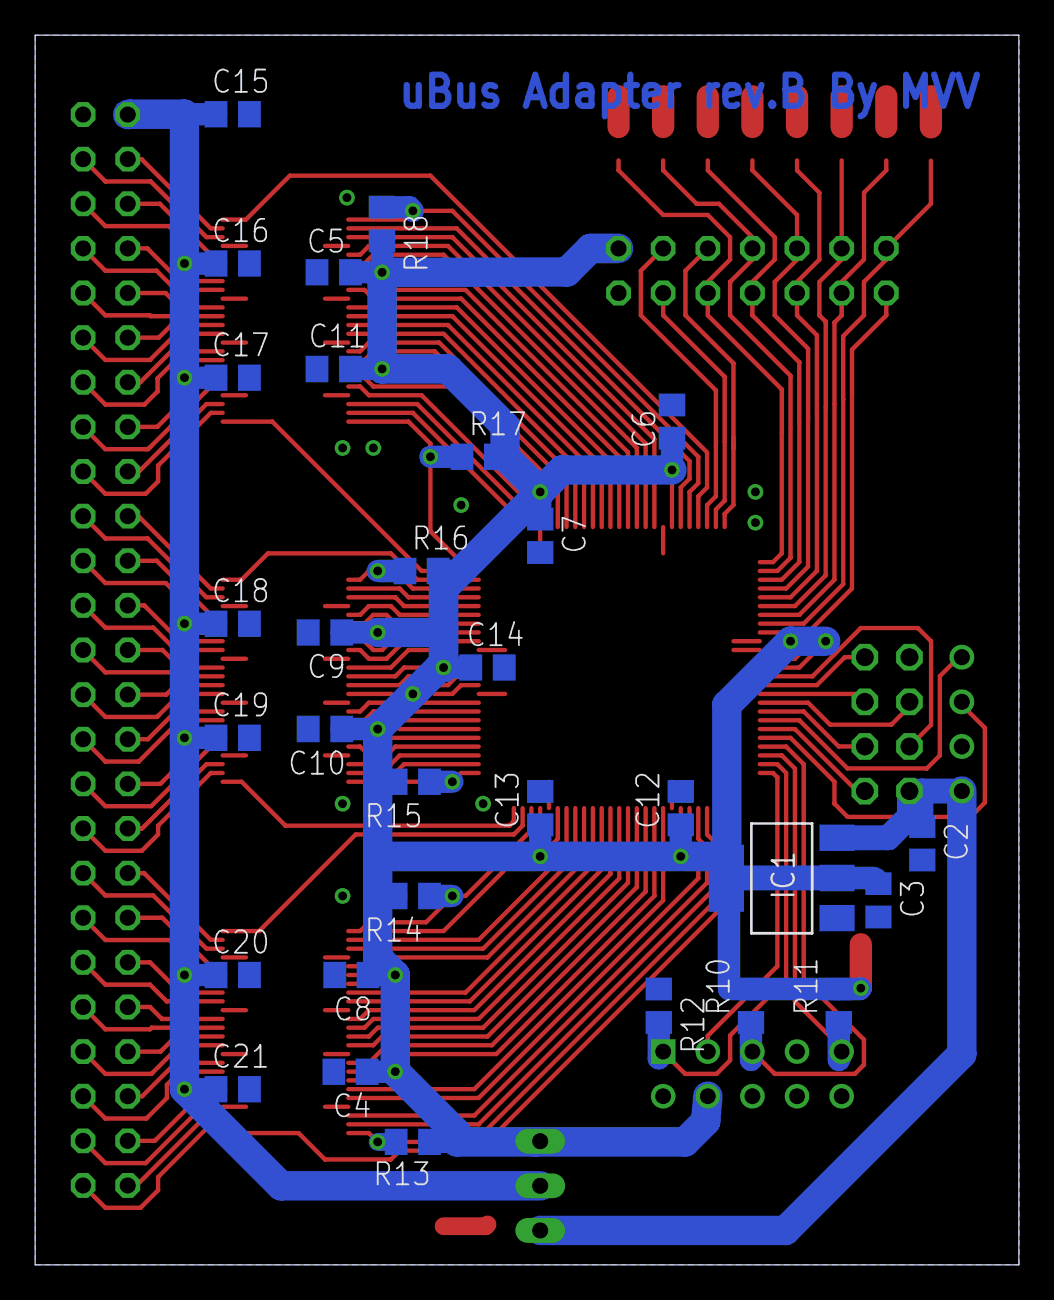
[picture p81: board ubus_rev_b.brd from below]

Board: 2 copper layers, 56.0 x 70.0 mm, 59 parts (30 on the bottom side), 145 nets.
