mvvproject/ReVerSE-U16/u16_board/modules/v2debug/debug01.brd

## EAGLE design u16_board/modules/v2debug/debug01.brd (2019-04-23)

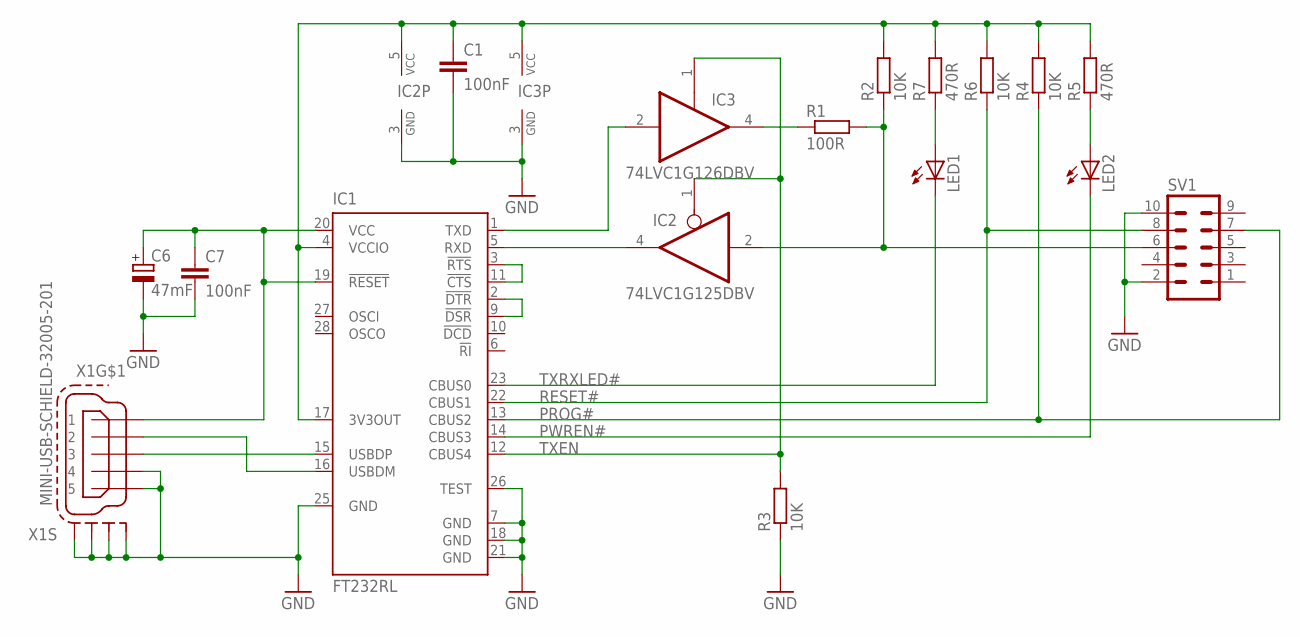
[picture p82: schematic debug01.sch]

Parts:
C1, C7: 100nF; C0603
C6: 47mF; CT3528
IC1: FT232RL; SSOP28
IC2: 74LVC1G125DBV; SOT23-5
IC3: 74LVC1G126DBV; SOT23-5
LED1, LED2: LEDCHIPLED_0805; CHIPLED_0805
R1: 100R; R0603
R2, R4, R6: 10K; R0603
R3: 10K; R1206
R5, R7: 470R; R0603
SV1: ML10
X1: MINI-USB-SCHIELD-32005-201; 32005-201

Connections:
+3V3: C1.1, IC1.4 (VCCIO), IC1.17 (3V3OUT), IC2.5 (VCC), IC3.5 (VCC), R2.2, R4.2, R5.2, R6.2, R7.2
+5V0: C6.+, C7.1, IC1.19 (!RESET), IC1.20 (VCC), X1.1
DBG: IC2.2 (I), R1.2, R2.1, SV1.6
DM: IC1.16 (USBDM), X1.2
DP: IC1.15 (USBDP), X1.3
GND: C1.2, C6.-, C7.2, IC1.7 (GND), IC1.18 (GND), IC1.21 (GND), IC1.25 (GND), IC1.26 (TEST), IC2.3 (GND), IC3.3 (GND), R3.1, SV1.2, SV1.10, X1.4, X1.5, X1.M1 (S1), X1.M2 (S2), X1.M3 (S3), X1.M4 (S4)
unnamed: LED2.A, R5.1
unnamed: IC3.4 (O), R1.1
unnamed: LED1.A, R7.1
unnamed: IC1.2 (!DTR), IC1.9 (!DSR)
unnamed: IC1.3 (!RTS), IC1.11 (!CTS)
PROG#: IC1.13 (CBUS2), R4.1, SV1.7
PWREN#: IC1.14 (CBUS3), LED2.C
RESET#: IC1.22 (CBUS1), R6.1, SV1.8
RXD: IC1.5 (RXD), IC2.4 (O)
TXD: IC1.1 (TXD), IC3.2 (I)
TXEN: IC1.12 (CBUS4), IC2.1 (OE), IC3.1 (OE), R3.2
TXRXLED#: IC1.23 (CBUS0), LED1.C

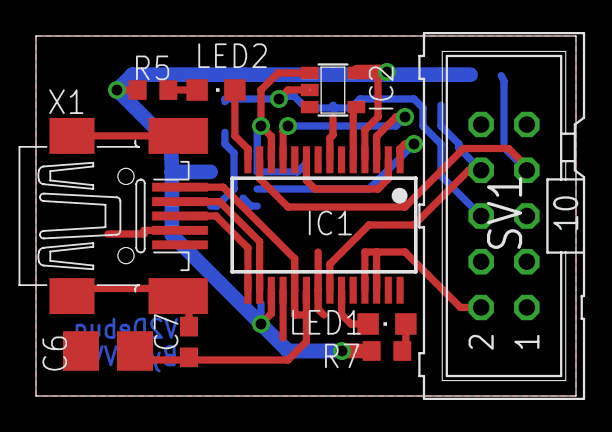
[picture p83: board debug01.brd from above]

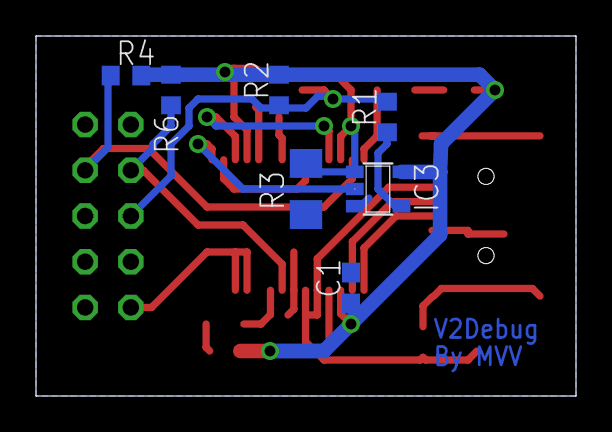
[picture p84: board debug01.brd from below]

Board: 2 copper layers, 30.0 x 20.0 mm, 17 parts (7 on the bottom side), 18 nets.
