mvvproject/ReVerSE-U16/u16_board/modules/usb_blaster/sch/usb_blaster_rev_a.brd

## EAGLE design u16_board/modules/usb_blaster/sch/usb_blaster_rev_a.brd (2019-04-23)

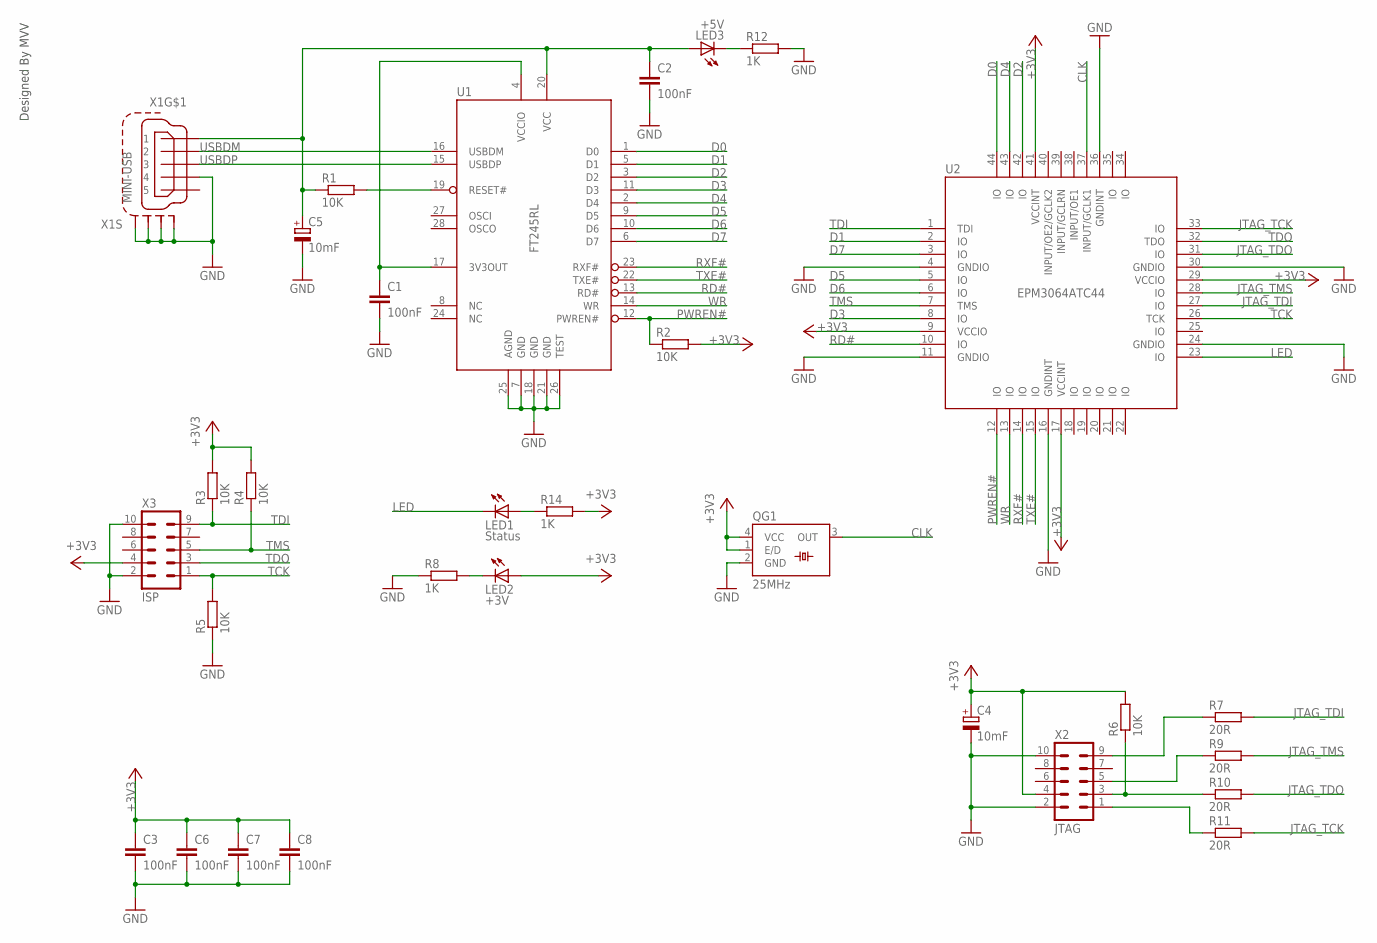
[picture p85: schematic usb_blaster_rev_a.sch]

Parts:
C1, C2, C3, C6, C7, C8: 100nF; C0805
C4, C5: 10mF; CT6032
LED1: Status; LED3MM
LED2: +3V; LED3MM
LED3: +5V; LED3MM
QG1: 25MHz; SM77H
R1, R2, R3, R4, R5, R6: 10K; R0805
R7, R9, R10, R11: 20R; R0805
R8, R12, R14: 1K; R0805
U1: FT245RL; SSOP28
U2: EPM3064ATC44; TQFP44
X1: MINI-USB; 32005-201
X2: JTAG; ML10
X3: ISP; MA05-2

Connections:
3V3OUT: C1.1, U1.4 (VCCIO), U1.17 (3V3OUT)
+3V3: C3.1, C4.+, C6.1, C7.1, C8.1, LED2.A, QG1.1 (E/D), QG1.4 (VCC), R2.2, R3.2, R4.2, R6.2, R14.2, U2.9 (VCCIO), U2.17 (VCCINT), U2.29 (VCCIO), U2.41 (VCCINT), X2.4, X3.4
+5V: C2.1, C5.+, LED3.A, R1.1, U1.20 (VCC), X1.1
CLK: QG1.3 (OUT), U2.37 (INPUT/GCLK1)
D0: U1.1 (D0), U2.44 (IO)
D1: U1.5 (D1), U2.2 (IO)
D2: U1.3 (D2), U2.42 (IO)
D3: U1.11 (D3), U2.8 (IO)
D4: U1.2 (D4), U2.43 (IO)
D5: U1.9 (D5), U2.5 (IO)
D6: U1.10 (D6), U2.6 (IO)
D7: U1.6 (D7), U2.3 (IO)
GND: C1.2, C2.2, C3.2, C4.-, C5.-, C6.2, C7.2, C8.2, QG1.2 (GND), R5.1, R8.1, R12.2, U1.7 (GND), U1.18 (GND), U1.21 (GND), U1.25 (AGND), U1.26 (TEST), U2.4 (GNDIO), U2.11 (GNDIO), U2.16 (GNDINT), U2.24 (GNDIO), U2.30 (GNDIO), U2.36 (GNDINT), X1.4, X1.M1 (S1), X1.M2 (S2), X1.M3 (S3), X1.M4 (S4), X2.2, X2.10, X3.2, X3.10
JTAG_TCK: R11.2, U2.33 (IO)
JTAG_TDI: R7.2, U2.27 (IO)
JTAG_TDO: R10.2, U2.31 (IO)
JTAG_TMS: R9.2, U2.28 (IO)
LED: LED1.K (C), U2.23 (IO)
unnamed: LED3.K (C), R12.1
unnamed: R1.2, U1.19 (RESET#)
unnamed: R7.1, X2.9
unnamed: R11.1, X2.1
unnamed: R6.1, R10.1, X2.3
unnamed: R9.1, X2.5
unnamed: LED2.K (C), R8.2
unnamed: LED1.A, R14.1
PWREN#: R2.1, U1.12 (PWREN#), U2.12 (IO)
RD#: U1.13 (RD#), U2.10 (IO)
RXF#: U1.23 (RXF#), U2.14 (IO)
TCK: R5.2, U2.26 (TCK), X3.1
TDI: R3.1, U2.1 (TDI), X3.9
TDO: U2.32 (TDO), X3.3
TMS: R4.1, U2.7 (TMS), X3.5
TXE#: U1.22 (TXE#), U2.15 (IO)
USBDM: U1.16 (USBDM), X1.2
USBDP: U1.15 (USBDP), X1.3
WR: U1.14 (WR), U2.13 (IO)

Notes on the sheet:
Designed By MVV

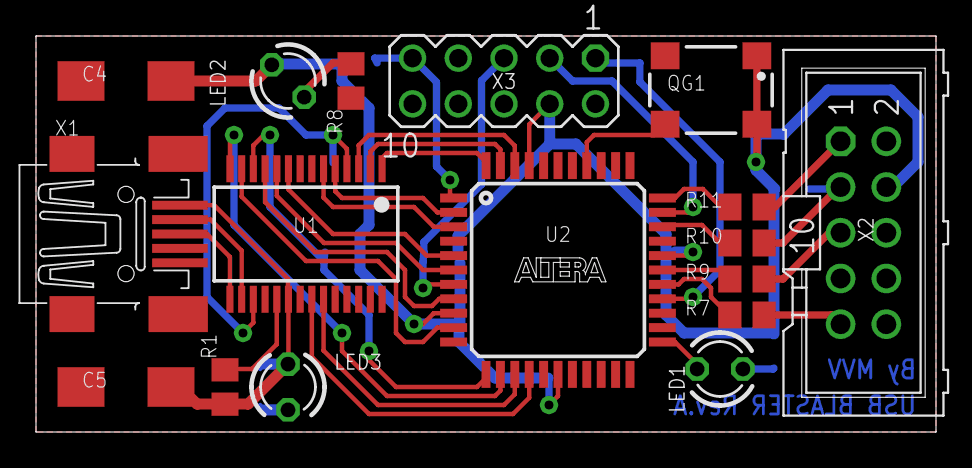
[picture p86: board usb_blaster_rev_a.brd from above]

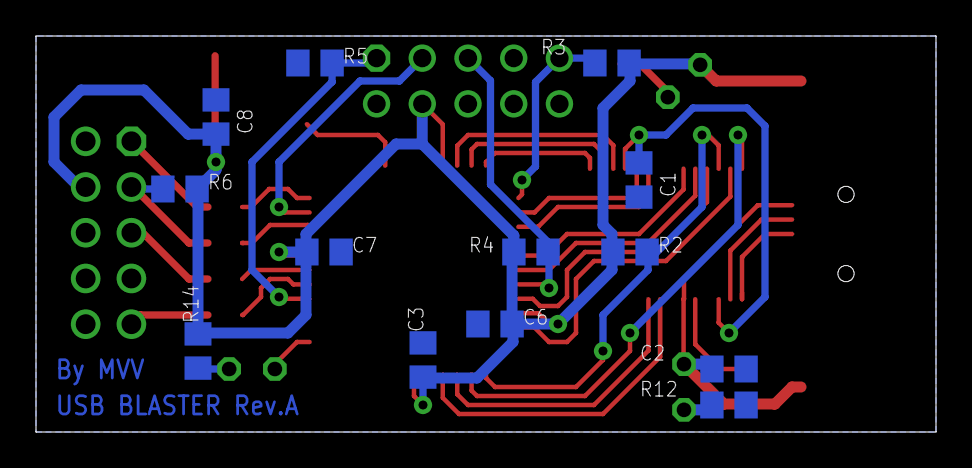
[picture p87: board usb_blaster_rev_a.brd from below]

Board: 2 copper layers, 50.0 x 22.0 mm, 30 parts (13 on the bottom side), 37 nets.
