mvvproject/ReVerSE-U16/u16_nextzx/rtl/hdmi/encoder.vhd

-- Adapted By MVV

library IEEE;
use IEEE.STD_LOGIC_1164.ALL;
use IEEE.STD_LOGIC_UNSIGNED.ALL;

entity encoder is
port (
	I_CLK     	: in  STD_LOGIC;
	I_DATA    	: in  STD_LOGIC_VECTOR (7 downto 0);
	I_C       	: in  STD_LOGIC_VECTOR (1 downto 0);
	I_BLANK   	: in  STD_LOGIC;
	O_ENCODED 	: out  STD_LOGIC_VECTOR (9 downto 0));
end encoder;

architecture rtl of encoder is
	signal xored  			: STD_LOGIC_VECTOR (8 downto 0);
	signal xnored 			: STD_LOGIC_VECTOR (8 downto 0);
	signal ones			: STD_LOGIC_VECTOR (3 downto 0);
	signal data_word		: STD_LOGIC_VECTOR (8 downto 0);
	signal data_word_inv		: STD_LOGIC_VECTOR (8 downto 0);
	signal data_word_disparity	: STD_LOGIC_VECTOR (3 downto 0);
	signal dc_bias			: STD_LOGIC_VECTOR (3 downto 0) := (others => '0');
	
begin
   -- Work our the two different encodings for the byte
   xored(0) <= I_DATA(0);
   xored(1) <= I_DATA(1) xor xored(0);
   xored(2) <= I_DATA(2) xor xored(1);
   xored(3) <= I_DATA(3) xor xored(2);
   xored(4) <= I_DATA(4) xor xored(3);
   xored(5) <= I_DATA(5) xor xored(4);
   xored(6) <= I_DATA(6) xor xored(5);
   xored(7) <= I_DATA(7) xor xored(6);
   xored(8) <= '1';

   xnored(0) <= I_DATA(0);
   xnored(1) <= I_DATA(1) xnor xnored(0);
   xnored(2) <= I_DATA(2) xnor xnored(1);
   xnored(3) <= I_DATA(3) xnor xnored(2);
   xnored(4) <= I_DATA(4) xnor xnored(3);
   xnored(5) <= I_DATA(5) xnor xnored(4);
   xnored(6) <= I_DATA(6) xnor xnored(5);
   xnored(7) <= I_DATA(7) xnor xnored(6);
   xnored(8) <= '0';
   
   -- Count how many ones are set in I_DATA
   ones <= "0000" + I_DATA(0) + I_DATA(1) + I_DATA(2) + I_DATA(3) + I_DATA(4) + I_DATA(5) + I_DATA(6) + I_DATA(7);
 
   -- Decide which encoding to use
	process (ones, I_DATA(0), xnored, xored)
	begin
		if ones > 4 or (ones = 4 and I_DATA(0) = '0') then
			data_word     <= xnored;
			data_word_inv <= NOT(xnored);
		else
			data_word     <= xored;
			data_word_inv <= NOT(xored);
		end if;
	end process;                                          

	-- Work out the DC bias of the dataword;
	data_word_disparity  <= "1100" + data_word(0) + data_word(1) + data_word(2) + data_word(3) + data_word(4) + data_word(5) + data_word(6) + data_word(7);

	-- Now work out what the output should be
	process(I_CLK)
	begin
		if (I_CLK'event and I_CLK = '1') then
			if I_BLANK = '1' then 
				-- In the control periods, all values have and have balanced bit count
				case I_C is            
					when "00"   => O_ENCODED <= "1101010100";
					when "01"   => O_ENCODED <= "0010101011";
					when "10"   => O_ENCODED <= "0101010100";
					when others => O_ENCODED <= "1010101011";
				end case;
				dc_bias <= (others => '0');
			else
				if dc_bias = "00000" or data_word_disparity = 0 then
					-- dataword has no disparity
					if data_word(8) = '1' then
						O_ENCODED <= "01" & data_word(7 downto 0);
						dc_bias <= dc_bias + data_word_disparity;
					else
						O_ENCODED <= "10" & data_word_inv(7 downto 0);
						dc_bias <= dc_bias - data_word_disparity;
					end if;
				elsif (dc_bias(3) = '0' and data_word_disparity(3) = '0') or 
					(dc_bias(3) = '1' and data_word_disparity(3) = '1') then
					O_ENCODED <= '1' & data_word(8) & data_word_inv(7 downto 0);
					dc_bias <= dc_bias + data_word(8) - data_word_disparity;
				else
					O_ENCODED <= '0' & data_word;
					dc_bias <= dc_bias - data_word_inv(8) + data_word_disparity;
				end if;
			end if;
		end if;
	end process;      
   
end rtl;
